MohammadFatehi/ThreePhaseInverter/20190705_152200[1].jpg

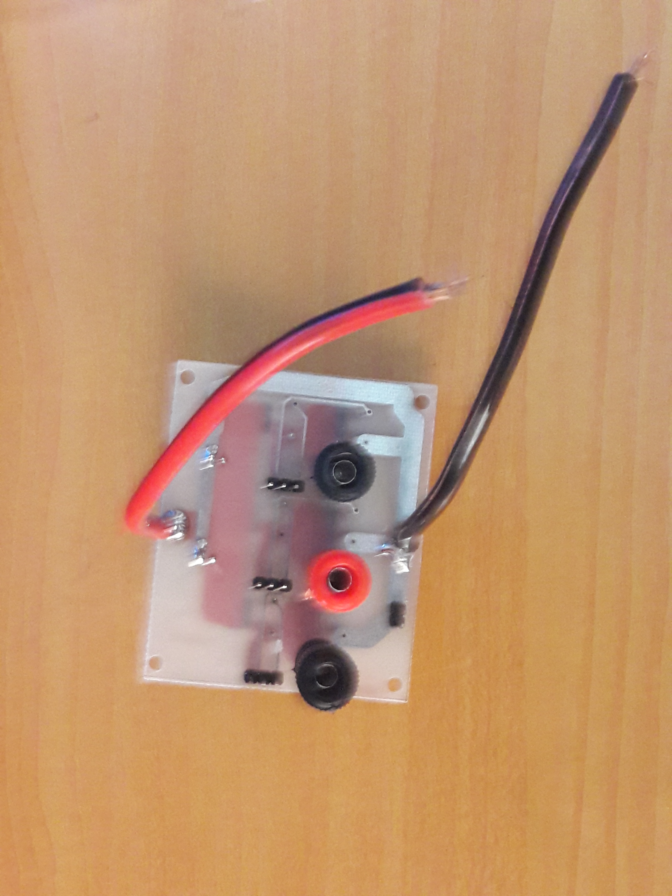
20190705_152200[1].jpg
