MohammadFatehi/ThreePhaseInverter/README.md

# ThreePhaseInverter
This is A Three Phase Inverter Project Developed for Using with Arduino boards.
Made By Mohammad Mahdi Fatehi.
Use PcbDoc and SchDoc for Building Your Own Inverter.
