MohammadFatehi/ThreePhaseInverter/InverterReport.pdf

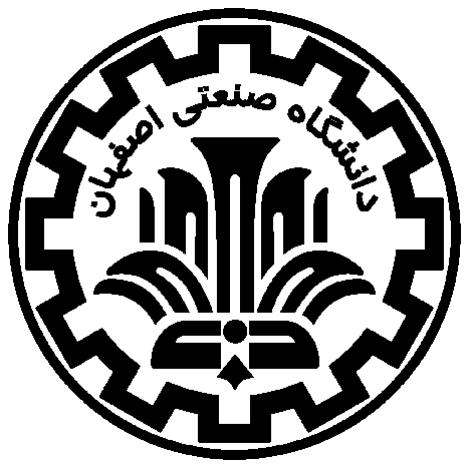
[picture p3: figure]

# طراحی و شبیه سازی به منظور ساخت اینورتر سه فاز

استاد راهنما: دکتر احسان ادیب دانشجو: محمدمهدی فاتحی

تیرماه 1398

الف

# قدردانی

همی شه برای انجام یک کار مطابق اهداف تعیین شده نیاز به ا ستفاده از راهنمایی و م ساعدت دیگران وجود دارد. این پروژه نیز از این قاعده مستثنی نبوده است. لذا قدردانی از این افراد کمترین کاری است که میتوان انجام داد. در این بخش ابتدایی از گزارش پروژه کار شنا سی ، الزم میدانم از ا ستاد عزیزم،آقای دکتر اح سان ادیب که در طول این 9 ماه با راهنمایی علمی و برقرار کردن امکان د ستر سی به آزمای شگاه الکترونیک صنعتی کمک ب سیار بزرگی در را ستای به ثمر ن ش ستن این پروژه دا شتند ت شکر کنم. همچنین از دو ست عزیزم، مجید عمومی که از ابتدای انجام این پروژه به بنده کمک کرده اند و در پایان از کلیه دوستانی که کمک رسان اینجانب بودهاند نیز تشکر میکنم.

1

## فهرست مطالب

قدردانی أ

فصل .1اینورترهای سوئیچینگ 3

.1-1 تعریف اینورتر و کاربردهای آن3 |
.1-2 طبقه بندی اینورترها3 |
.1-3 اینورتر تک فاز نیم پل4 |
.1-4 اینورتر تک فاز تمام پل4 |
.1-5 اینورتر سه فاز5 |
.1-6 تحلیل فوریه اینورتر سه فاز شش پله ای7 |
.1-7 اینورتر سه فاز PWM8 |
.1-8 کاربرد اینورتر سه فاز - کنترل سرعت موتورهای AC 11 |
.1-9 اینورترهای سه فاز چندسطحی11 |
.1-10 خالصه 12

فصل .2طراحی اینورتر سه فاز 13

.2-1 تعریف پروژه و مشخصات آن13 |
.2-2 بلوک دیاگرام پروژه13 |
.2-3 معرفی بخش های مختلف پروژه14 |
.2-4 مروری مختصر بر طراحی PWM20 |
.2-5 مدار فیلتر خروجی22 |

فصل .3شبیه سازی اینورتر سه فاز 25

.3-1 شبیه سازی مدار تولید پالس های مربعی سه فاز با DFF 25 |
.3-2 شبیه سازی مدار قدرت اینورتر سه فاز شش پله ای و نتایج حاصل از آن26 |
.3-3 شبیه سازی مدار قدرت اینورتر سه فاز PWM و نتایج حاصل از آن31 |
.3-4 مقایسه بین عملکرد اینورتر شش پلهای با اینورتر PWM33 |

فهرست مطالب ■ 2

فصل .4محدود کننده جریان و ولتاژ خروجی 35

.4-1 محدود کننده جریان خروجی35 |
.4-2 محدود کننده ولتاژ خروجی37 |
.4-3 طراحی محدود کننده جریان37 |

فصل .5ساخت اینورتر سه فاز شش پله ای 39

.5-1 معرفی بخش های مختلف PCB39 |
.5-2 برد سیگنال39 |
.5-3 برد قدرت.. 42 |
.5-4 دسترسی به فایلهای پروژه43 |

مراجع 45

3

# 1 فصل .1 اینورترهای سوئیچینگ

در این فصل ابتدا به معرفی و تشریح کاربرد اینورترهای سوئیچینگ وتوپولوژیهای مورد استفاده در صنعت پرداخته و سپس در فصول بعدی به تشریح بخشهای مختلف این پروژه میپردازیم.

1-1 تعریف اینورتر و کاربردهای آن

اینورترها در سااده ترین حالت، مدارهایی هساتند که سایگنال DC را به سایگنال AC تبدیل میکنند. لزوم انجام این کار از آن جهت است که معموالً عالقه داریم بتوانیم یک میزان مشخصی توان را از یک منبع DC دریافت کرده و به
3 | موتورهای AC، منابع تغذیه اضاطراری | 2 | یک بار AC تحویل دهیم. در کاربردهایی نظیر کنترل سارعت

، نیروگاه های
خورشیدی، تغذیه لوازم AC از باتری خودرو و دیگر کاربردها از اینورترها استفاده می شود.

1-2 طبقه بندی اینورترها

اینورترهای سوئیچینگ از جنبه های مختلفی قابل طبقه بندی ه ستند. از حیث تعداد فاز، نحوه کلیدزنی، کمیتی که از حالت DC به AC تبدیل می شااود و دیگر موارد. وابسااته به آنکه چه میزان هزینهای برای ما مقدور اساات و در چه کاربردی نیاز به اینورتر داریم، اینورتر مناسب انتخاب میشود. اینورترهای تک فاز در دو نوع نیم پل و تمام پل بسیار مورد اساااتفاده هساااتند. از حیث کلیدزنی، اینورترهای موج مربعی با اینورترهای موج ساااینوسااای متفاوت هساااتند.

1Switching Inverters
2Speed Control
3UPS

فصل .1 اینورترهای سوئیچینگ ■ 4

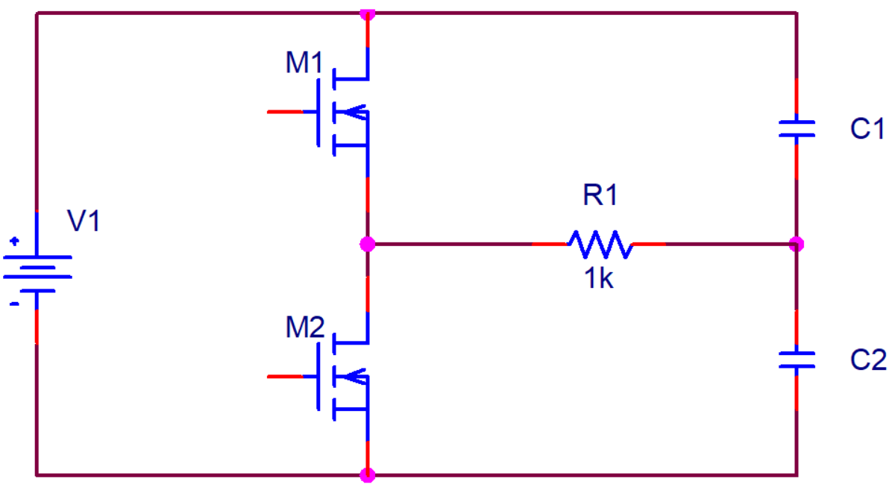
[picture p4: figure]

اینورترهای نوع جریان در برابر اینورترهای نوع ولتاژ هم دیگر دسااته بندی اساات که میتوان انجام داد. در این پروژه
1 | هدف ساخت یک اینورتر ولتاژ ، سه فاز با خروجی موج مربعی)شش پله ای(
است.

1-3 اینورتر تک فاز نیم پل

2

در ابتدا از ساختار تک فاز نیم پل به عنوان یکی از پایهای ترین ساختارهای اینورتری شروع میکنیم. در این ساختار که در شکل )1-1( نمایش داده شده است 2 خازن داریم که ولتاژ آنها با یکدیگر برابر بوده و برابر با نصف ولتاژ منبع تغذیه 1V است. این دو خازن توسط دو کلید دو سمت بار AC سوئیچ میشوند. ابتدا کلید 1Sبسته میشود تا ولتاژی برابر با 1/2V –روی بار قرار گیرد. سپس کلید دیگر ب سته و کلید قبلی باز می شود تا ولتاژی برابر با 1/2V+ دو سر بار 1R قرار گیرد. به این ترتیب با ادامه دادن این روند، یک ولتاژ مربعی با ساااطوث مثبت و منفی دوسااار بار قرار میگیرد.

1-4 اینورتر تک فاز تمام پل

3

در ساختار قبلی ولتاژی که روی بار قرار میگیرد دارای دو سطح بیشتر نیست. اگر بخواهیم سطح صفر ولت را نیز به این سطوث ا ضافه کنیم باید از ساختار تمام پل ا ستفاده کنیم. این ساختار دو کلید بی شتر دا شته و مدار گیت درایو به مراتب پیچیدهتری نساابت به اینورتر نیم پل خواهد داشاات. همچنین عدم همپوشااانی الگوی کلیدزنی در این اینورتر اهمیت دارد. این ساختار در شکل )1-2( ن شان داده شده ا ست. در این ساختار ابتدا کلیدهای 1M و 4M ب سته شده ولتاژ مثبت 1V روی بار قرار میگیرد. ساپس کلید های 1M و 3M بساته شاده و ولتاژ صافر روی بار قرار میگیرد.

1Six Step
2 Half Bridge Single Phase Inverter 3 Full Bridge Single Phase Inverter

شکل .1-1یک اینورتر تک فاز نیم پل

فصل .1 اینورترهای سوئیچینگ ■ 5

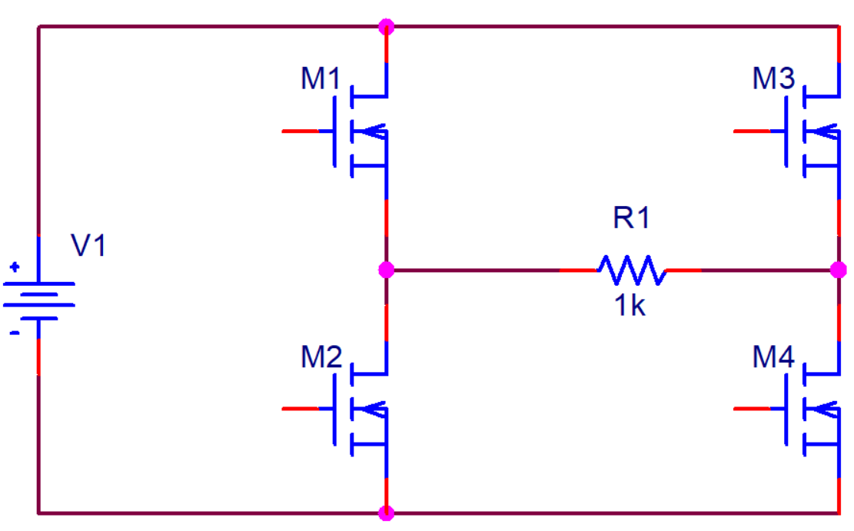
[picture p5: figure]

سپس نوبت به بسته شدن کلید های 3M و 2M میرسد تا ولتاژ منفی 1Vروی بار قرار گیرد. در نهایت 2M و 4M بسته می شوند و مجددا ولتاژ صفر روی بار قرار میگیرد. این روند ادامه پیدا می کند تا یک شکل موج با 3 سطح در
1 | خروجی داشته باشیم. اثبات میشود این خروجی ، نسبت به حالت نیم پل مقدار
THD کمتری دارد و به شکل موج
سینوسی موردنظر نزدیک تر است. وجود یک فیلتر دقیق در خروجی میتواند مولفه سینوسی نسبتا خالصی را از این شکل موج استخراج کند.
هر دو اینورتر یاد شاده دارای محاسابات ریاضای مفصالی در حوزه فوریه بوده که چون به موضاوع این پروژه مرتبط نیسااتند به آنها پرداخته نمیشااود. در بخش بعدی به اینورتر سااه فاز پرداخته و در ادامه این فصاال محاساابات ریاضاای مربوط به این نوع اینورتر را مطرث میکنیم. همچنین ذکر این نکته الزم اساات که ساااختار اینورتر تک فاز به دو نوع مذکور ختم نمیشااود و انواع دیگری نیز دارد. همچنین در روش سااوئیچزنی اینورتر PWM نیز کاربرد فراوانی که این نوع اینورتر در این فصل برای اینورتر سه فاز شرث داده میشود.

1-5 اینورتر سه فاز

این نوع اینورتر میتواند از یک ولتاژ DC ، 3 ولتاژ AC با دامنه یکساااان و اختالف فاز 120 درجهای ایجاد کند. به طور کلی اینورتر سه فاز در مواردی کاربرد دارد که خواهان پردازش توان برای بارهای سه فاز AC هستیم. این بارها شامل انواع موتورهای سنکرون و آ سنکرون)القایی( بوده و کاربردهای ب سیاری دارد. در این نوع اینورتر یک شاخه شامل دو کلید به ساختار تمام پل تک فاز افزوده می شود و با پیروی از الگوی کلیدزنی م شخ صی یک خروجی سه فاز تولید میگردد. ساختار این اینورتر به صورت شکل )1-3( است. در این شکل فازهای A ، B و C مشخص شده اند و یک بار ستاره سه فاز به این فازها مت صل شده ا ست. نقطه N یک نقطه فر ضی ات صال ستاره بوده و زمین مدار مطابق شکل جدا میباشد. مطابق این شکل هر سوئیچ از هر شاخه اگر روشن باشد سوئیچ جفت آن باید خاموش باشد

1Total Harmonic Distrotion

شکل .2-1یک اینورتر تک فاز تمام پل

فصل .1 اینورترهای سوئیچینگ ■ 6

تا از اتصاااال کوتاه شااادن منبع DC جلوگیری شاااود. همچنین هر عمل کلید زنی در هر /6T زمان یک بار اتفاق
که ولتاژهای و سط هر شاخه ن سبت به | ، 0VBو 0VC | میافتد)به عبارتی هر 60 درجه(. مطابق این ساختار ولتاژهای 0VA
زمین مدار اسااات دارای دو ساااطح VDC+و صااافر خواهند بود. ولتاژهای VAB، VBCو VCAولتاژهای خط بوده و

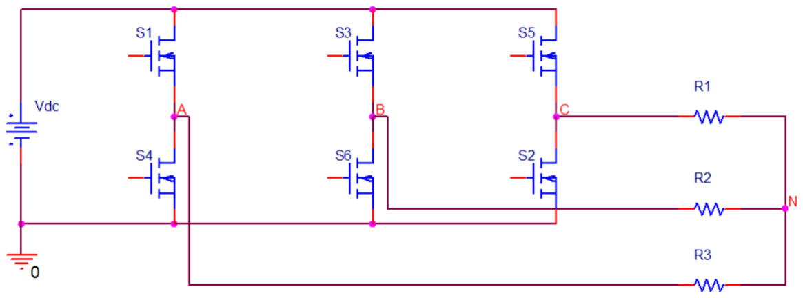
[picture p6: figure]

دارای سطوث VDC+ ، VDC- و صفر میباشند. الگوی کلید زنی در شکل )1-4( نشان داده شده است.

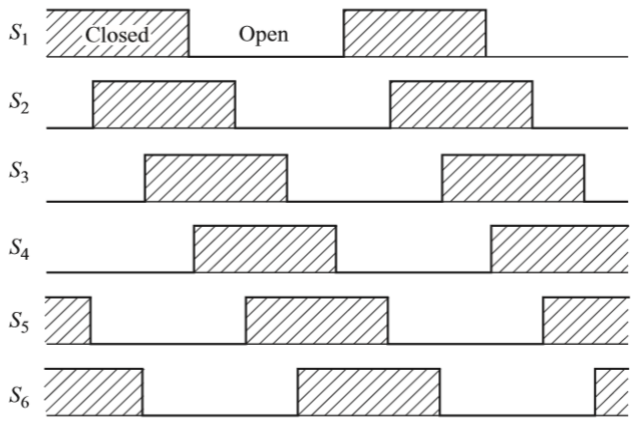
[picture p7: figure]

چنین الگویی شکل موج هایی مطابق شکل )1-5( ایجاد میکند. م شاهده می شود که ولتاژهایی شبیه به سینو سی در خروجی داریم که توساط فیلتر میتوان مولفه ساینوسای آنها را جدا نمود. شاکل )1-6( ولتاژ هر فاز را نشاان میدهد. مالحظه می شاود که این ولتاژ ها دارای ساطوث VDC 1/3 + ، VDC 2/3 + ، VDC 1/3 - ، VDC 2/3 – میباشاد. مالحظه میشود که در یک پریود کلیدزنی ، ولتاژهای فاز 6 حالت مختلف را طی میکنند. به این خاطر به این اینورتر 1 شش پله

نیز گفته میشود.

1Six Step Inverter

شکل .3-1یک اینورتر سه فاز

شکل .4-1الگوی کلیدزنی اینورتر سه فاز

فصل .1 اینورترهای سوئیچینگ ■ 7

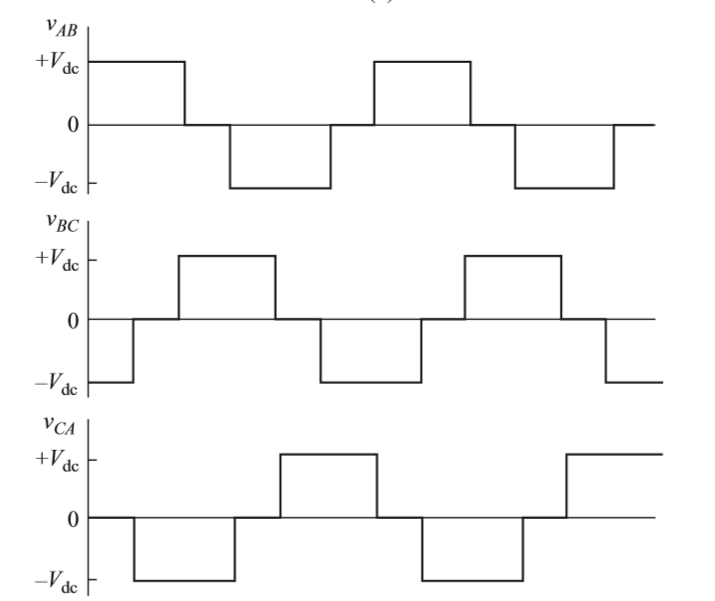
[picture p8: figure]
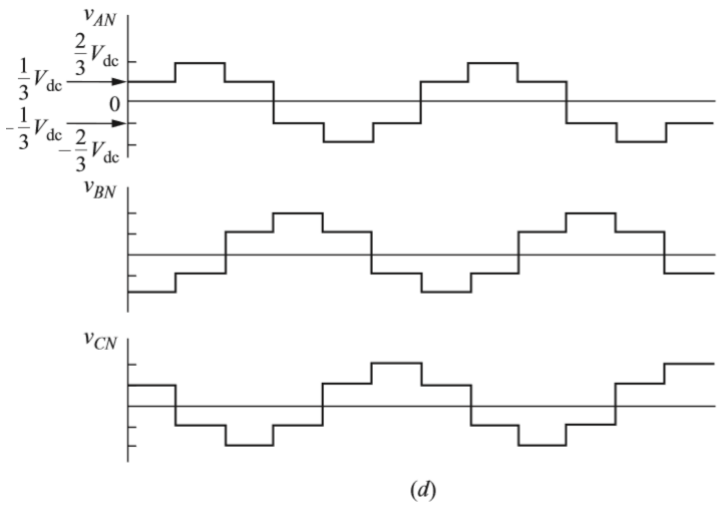
[picture p9: figure]

1-6 تحلیل فوریه اینورتر سه فاز شش پله ای

در این بخش به محاسبات مربوط به اینورتر سه فاز شش پلهای میپردازیم. سری فوریه مربوط به شکل موج خروجی )ولتاژ فاز یا ولتاژ خط( دارای یک مولفه پایه با فرکانس برابر با فرکانس کلیدزنی اسااات. هارمونیک های مربوطه از مرتبه فرکانسااای ±1k6( به ازای ...1,2, = k ) هساااتند. هارمونیک مرتبه 3 و مضاااارب آن وجود ندارند. همچنین

شکل .5-1 ولتاژهای خط اینورتر سه فاز

شکل .6-1 ولتاژهای فاز اینورتر سه فاز

فصل .1 اینورترهای سوئیچینگ ■ 8

هارمونیک زوج نیز ندارد. به ازای بار ستاره که نقطه خنثی آن به زمین مدار مت صل ن شده با شد ، ضرایب سری فوریه ولتاژ خروجی خط و فاز به صورت زیر هستند :

Vn.L-L= |
4VDC

nπ

cos (n
π

6

)| , n = 1,5,7,11,13,… | (1-1)

Vn.L-N= |
2VDC

3nπ

[2+ cos (n
π

3

) - cos (n
2π

3

) ]| , n = 1,5,7,11,13,… | (1-2)

میزان THD مربوط به هر دو ولتاژ خط و فاز خروجی اینورتر در حدود 31 درصد میباشد. این میزان برای جریان بار بخصاااوا بار RL به میزان قابل توجهی کمتر خواهد بود. همچنین فرکانس شاااکل موج خروجی توساااط فرکانس سوئیچینگ قابل تغییر است. دامنه شکل موج خروجی توسط تغییر ولتاژ منبع تغذیه قابل تغییر میباشد.

1-7 اینورتر سه فاز PWM

1

تا کنون به معرفی سااختارهای پایه ای اینورترها پرداختهایم. در این بخش با اساتفاده از سااختار بخش)1-6( به معرفی روشاای به نام PWM میپردازیم که کامال مربوط به نحوه کلیدزنی میشااود. این روش مزایا و معایبی دارد. مزایایی مانند فیلترینگ سااااده تر برای حذف هارمونیک ها و همچنین قابلیت کنترل دامنه خروجی. عیب این روش پیچیدگی مدارات گیت درایو و همچنین باالتر رفتن ناگهانی فرکانس ساوئیچینگ و ایجاد مشاکالت مربوط به آن میشاود. در این بخش ابتدا تعاریف مربوط به این روش کلیدزنی که در اینورتر تک فاز نیز مورداستفاده است بیان شده و سپس به ارائه محاسبات انجام گرفته برای اینورتر سه فاز میپردازیم. در این روش یک موج سینوسی مرجع با یک موج حامل مثلثی مقایسه میشود. فرکانس پایه خروجی برابر با فرکانس موج مرجع میباشاااد و دامنه خروجی متناساااب با نسااابت دامنه موج مرجع و موج حامل اسااات. بدین ترتیب با تغییر فرکانس موج مرجع و تغییر دامنه آن میتوان یک شاااکل موج با دامنه و فرکانس دلخواه در خروجی داشااات. البته مطابق قبل هارمونیکهایی نیز در خروجی وجود دارند. دو تعریف مهم در بحث PWM تعاریف زیر هستند : 1( نرخ مدوالساایون فرکانساای )mf ): به صااورت نساابت فرکانس موج حامل به موج مرجع تعریف میشااود. افزایش این کمیت ، بدان معنا اسااات که فرکانسااای که در آن هارمونیک ها اتفاق میافتند به فرکانساااهای باالتری منتقل می شود. پس مقادیر زیاد مطلوب ه ستند. به این ترتیب چون هارمونیک ها ن سبت به فرکانس اصلی)که برابر فرکانس موج مرجع است( بسیار دور هستند ، فیلتر کردن آنها نیز ساده تر میشود. مشکل در این جا بوجود میآ ید که باال بردن mf یعنی باال بردن فر کانس کل یدزنی که خود مساااائلی مان ند تل فات

1Pulse Width Modulation

فصل .1 اینورترهای سوئیچینگ ■ 9

ساوئیچینگ ، زمان روشان و خاموش شادن و... را دربر دارد و باعث افزایش هزینه و پیچیدگی طراحی می شود.
2( نرخ مدوالسیون دامنه )ma ): به صورت نسبت دامنه موج مرجع به دامنه موج حامل تعریف میشود.به ازای ma کوچک تر از یک ، دامنه هارمونیک ا صلی به صورت خطی با اندازه ولتاژ منبع تغذیه متنا سب میشود. اهمیت تغییر دامنه در روش PWM از آن جهت است که بخصوا در جایی که منبع تغذیه از رگوالسیون خوبی برخوردار نیساات میتوان با تغییر نرخ مدوالساایون دامنه نوعی از رگوالساایون در خروجی را بوجود
آورد. به ازای نرخ مدوالسااایون دامنه بزرگتر از یک حالت فرامدوالسااایون پیش آمده و دامنه به صاااورت
غیرخطی تغییر میکند.
اکنون به توضااایح روش PWM و شاااکل موج های مربوطه میپردازیم. در این روش جفت کلیدهای )4S1,S )و )5S2,S )و )6S3,S )با یکدیگر کنترل میشوند. به آن معنا که در هر جفت اگر یک کلید و صل با شد دیگری قطع است. هر جفت کلید نیازمند یک موج مرجع سینوسی مختص به خود میباشد. یعنی در این روش برای اینورتر سه فاز 3 موج مرجع که هم دامنه و هم فرکانس اند و با یکدیگر 120 درجه اختالف فاز دارند نیاز اسااات. در شاااکل )1-7( یک شکل موج حامل مثلثی و این 3 شکل موج سینوسی مرجع را نمایش میدهد. شکل موج باال به صورت خالصه نتایجی به صورت زیردارد :

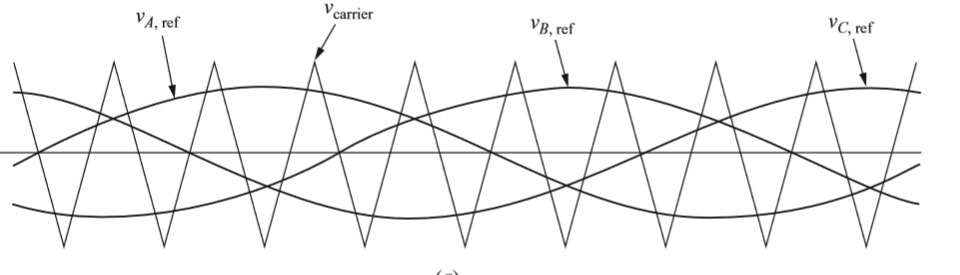
[picture p10: figure]

کلید 1S روشن است وقتی که VTRIG > VA کلید 2S روشن است وقتی که VTRIG > VC کلید 3S روشن است وقتی که VTRIG > VB کلید 4S روشن است وقتی که VTRIG < VA کلید 5S روشن است وقتی که VTRIG < VC کلید 6S روشن است وقتی که VTRIG < VB

شکل .7-1 موج حامل و امواج مرجع

فصل .1 اینورترهای سوئیچینگ ■ 10

در این روش اگر فرکانس موج حامل به صاورت یک عدد صاحیح فرد و مضارب 3 فرکانس مرجع )مانند 3 ، 9 ، 15 و... برابر فرکانس مرجع( باشاد هارمونیک ها کاهش مییابند. در شاکل )1-8( شاکل موج های خروجی نمایش داده شده است.

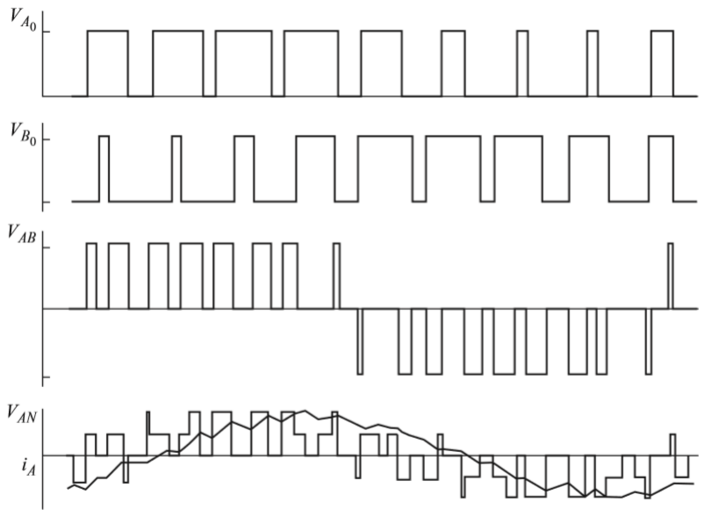
[picture p11: figure]

به دلیل پیچیدگی محاسبات سری فوریه در کتب مختلف جداولی ارائه شده است که دامنه هر ضریب سری فوریه به صورت نرمالیزه شده برح سب دامنه منبع تغذیه ورودی داده شده ا ست. برای اینورتر سه فاز جدولی به صورت زیر وجود دارد :

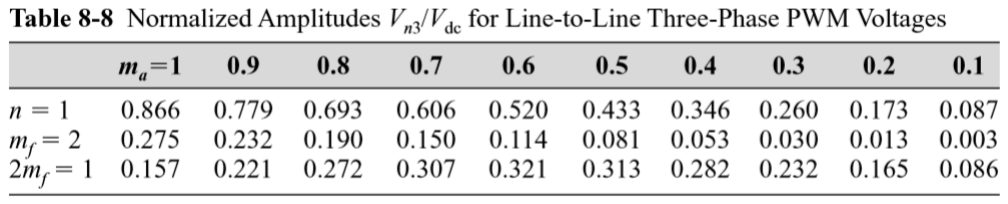
[picture p12: figure]

مشاهده میشود که به ازای ma موردنظر ما ، دامنه ضرایب فوریه مشخص شده اند. در مرجع دوم این پروژه روابط و جداول دیگری نیز آورده شده است که برحسب نیاز میتواند استفاده شود. در این پروژه هدف طراحی ، شبیه سازی و ساخت یک اینورتر شش پله ای ساده است و به طراحی نوع PWM پرداخته نمیشود.

شکل .8-1 ولتاژهای خروجی اینورتر سه فاز PWM

شکل .9-1 دامنه نرمالیزه VDC3/Vn برای ولتاژهای خط به خط

فصل .1 اینورترهای سوئیچینگ ■ 11

1-8 کاربرد اینورتر سه فاز - کنترل سرعت موتورهای AC

یکی از کاربردهای مهم اینورترها در بحث کنترل سرعت موتور القایی است. در این موتورها سرعت سنکرون توسط رابطه زیر با تعداد قطب موتور و فرکانس برق اعمالی به موتور رابطه دارد :
ωs=

2ω

P

(1-3)
با تغییر فرکانس اعمالی به موتور میتوان مستقیما بر سرعت چرخش حوزه دوار )سرعت سنکرون( اثر گذاشت.در این موتورها عدد لغزش به صورت زیر تعریف میشود :
s =

ωS-ωr

ωs

(1-4)
مالحظه میشود که این عدد برح سب سرعت روتور بوده و با گ شتار هم متنا سب ا ست. بدین ترتیب با تغییر فرکانس اعمالی سااارعت موتور تغییر کرده ولی اگر فرکانس کاهش یابد و ولتاژ اعمالی به موتور از لحاظ دامنه ثابت بماند ، شار فا صله هوایی آنقدر زیاد شده که ا شباع میشود و مطلوب ا ست که شار فا صله هوایی در مقدار نامی خود ثابت بماند و همزمان با تغییر فرکانس ، ولتاژ اعمالی هم به همانصااورت تغییر کند به عبارتی نساابت ولتاژ به فرکانس ثابت بماند. به این روش کنترل سرعت موتور القایی ، روش f/V ثابت گویند.

اینورتر سه فاز PWM یک مدار منا سب برای کنترل سرعت به روش یاد شده میبا شد زیرا هم قابلیت تغییر فرکانس دارد و هم قابلیت تغییر دامنه. لذا استفاده از اینورتر غیر PWM مثال اینورتر شش پلهای به دلیل عدم امکان تغییر دامنه خروجی ، کنترل به این روش را ناممکن میکند و مشااکالت روش تغییر فرکانس مثل اشااباع شاادن شااار مغناطیساای بوجود میآید. البته میتوان به کمک یک مبدل DC-DC منبع تغذیه را تنظیم کرد و از اینورتر شااش پلهای صاارفا برای تغییر فرکانس استفاده نمود. استفاده از مبدلهای AC-AC به لینک DC نیز یکی دیگر از راههای کنترل سرعت به روش مذکور به کمک اینورتر شش پلهای است.

1-9 اینورترهای سه فاز چندسطحی

1

چه در روش PWM و چه در روشاااهای دیگر کلیدزنی اینورتر ، میزان THD خروجی بنابر کاربرد میتواند اهمیت فراوانی داشااته باشااد. هرچه THD کوچک تر باشااد خروجی ما به یک سااینوساای واقعی نزدیکتر اساات. با اینحال اینورترهای چندساطحی نیز وجود دارند که خروجی از تعداد ساطوث ولتاژ بیشاتری برخوردار بوده و در نتیجه اثبات میشود که میزان THD کمتری خواهد داشت. یک نمونه از اینورتر سه فاز چندسطحی در شکل )1-10( نشان داده شده است.

1Multi-Level Diode-Clamped Three Phase Inverters

فصل .1 اینورترهای سوئیچینگ ■ 12

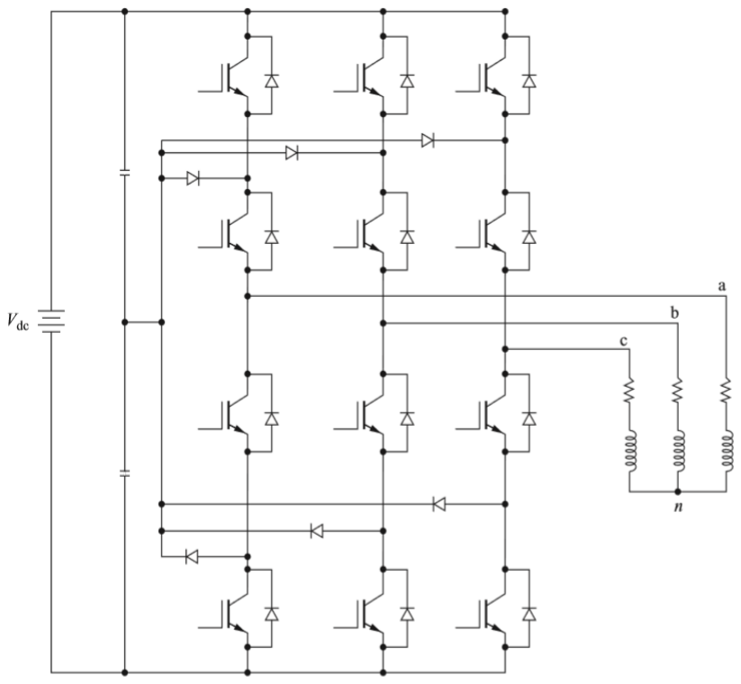
[picture p13: figure]

1-10 خالصه

- مبدلهای تمام پل و نیم پل میتوانند برای تولید خروجی AC از ورودی DC استفاده شوند.
- اینورترها به انواع تک فاز و سااه فاز تقساایم بندی میشااوند که بسااتگی به بار موردنظر مورد اسااتفاده قرار میگیرند
- اینورتر سه فاز شش پلهای پایهای ترین ساختار اینورتر سه فاز است.
- میزان THD در روش PWM نسبت به ساختار شش پلهای بسیار کمتر است.
- روش PWM دارای مدارات گیت درایو پیچیده تر است و هزینه باالتری در برخواهد داشت.
- در روش PWM عالوه بر کنترل فرکانس بر دامنه خروجی نیز کنترل داریم.
- کنترل سرعت موتور القایی یکی از کاربردهای عمده اینورتر سه فاز ا ست که با اینورتر PWM و به روش ولتاژ فرکانس ثابت میتوان کنترل مناسبی بر سرعت داشت.

شکل .10-1یک اینورتر سه فاز چندسطحی Clamped-Diode

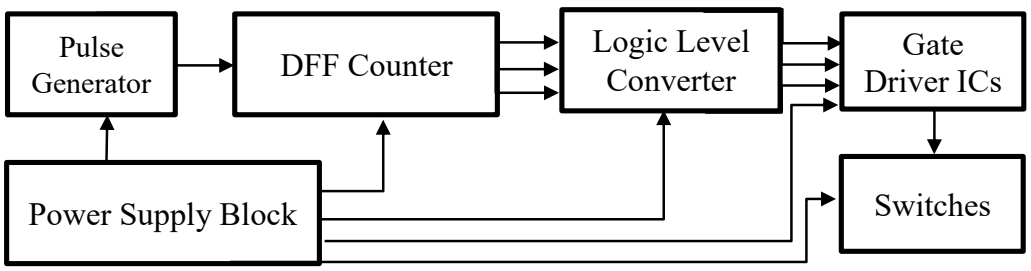
[picture p14: figure]
Pulse; Generator; DFF Counter; Power Supply Block; Logic Level Converter; Gate Driver ICs; Switches

3

# فصل .2طراحی اینورتر سه فاز

.2-1 تعریف پروژه و مشخصات آن

هدف این پروژه طراحی یک اینورتر سه فاز شش پله ای به صورت ماژوالر است که قبال در بخش)1-5( معرفی
1 | شاااد. این اینورتر به منظور کاربردهای ولتاژ پایین مانند درایور موتورهای

BLDC که نیاز به جریان باالیی در هنگام
راهاندازی و زیر بار دارند طراحی ، شبیه سازی و ساخته میشود. این اینورتر قابلیت تغییر فرکانس با استفاده از بلوتوث را نیز دارا بوده و میتواند ولتاژهای مربعی سااه فاز تا دامنه 20 ولت خط به خط و جریان دهی 20 آمپر را فراهم آورد. بازه تغییر فرکانس از حدود 30 هرتز تا 3 کیلوهرتز خواهد بود. توان نامی این اینورتر در حدود 400 وات است.

.2-2 بلوک دیاگرام پروژه

این پروژه از بخش های مختلفی تشااکیل شااده اساات که طبق بلور دیاگرام زیر با یکدیگر ارتباط دارند. این بلور دیاگرام کامل نبوده و بخش به مربوط به بلوتوث در آن وجود ندارد.

1Brushless DC

فصل .2 طراحی اینورتر سه فاز ■ 14

.2-3 معرفی بخش های مختلف پروژه

مدار این پروژه به دو مدار کوچک تر تق سیم شده ا ست. یک مدار که برای گیت درایو و مدار دیگر مدار قدرت که فقط شامل سوئیچ ها و سن سورها ست. این مدار در ف صل 5 آورده شده ا ست و در بخش های بعدی بر ا ساس همین مدار به توضیح بخش های مختلف آن میپردازیم. مهترین بخش مدار این پروژه، کلیدهای قدرت بوده که باید بتوانند ولتاژ و جریان خواسته شده را پشتیبانی کنند. به طور کلی بخش های مختلف این پروژه شامل موارد زیر است : 1( کلیدهای قدرت

1
و توپولوژی اینورتر سه فاز
2( مدار گیت درایو
2
با آیسی 2111IR
3( مدار مولد پالس با فرکانس متغیر
3DFF | 4 )مدار تولید پالس های مربعی سه فاز با استفاده از
5( مدار مبدل سطوث منطقی
6( ماژول بلوتوث به منظور کنترل فرکانس توسط کاربر 7( مدار فیلتر خروجی
الزم به ذکر اسات که طراحی صاورت گرفته در نهایت در فصال بعدی وارد مراحل سااخته شاده و همراه پروژه ارائه میگردد.
.2-3.1 کلیدهای قدرت و توپولوژی اینورتر کلیدهای قدرت مورد اساااتفاده در این پروژه باید بتوانند ولتاژهای معکوسااای به اندازه ولتاژ خط به خط که نهایتا 20 ولت اسات را تحمل کنند. دقت شاود که این 20 ولت دامنه موج مربعی خروجی اسات. همچنین جریان گذرنده قابل تحمل نیز باید بیش از 20 آمپر باشد. به منظور پایین آمدن تلفات ناشی از مقامت درین سورس و عدم تاثیر گذاری آن بر راندمان کلی سیستم نیز از کلیدهایی باید استفاده کرد که مقاومت درین سورس کمی در جریان نامی سیستم داشته
2 | باشند تا تلفات
RDSI حداقل شود. به دلیل آنکه در این پروژه از روش PWM اسفاده نمیشود و نیاز به موج حامل
با فرکانس باال نداریم ، تلفات سوئیچینگ بسیار ناچیز خواهد بود. عالوه بر نکات یاد شده کلیدی که سرعت خاموش و روشاان شاادن باالیی داشااته باشااد نیز در بهبود تلفات سااوئیچینگ نقش عمده ای ایفا خواهد کرد. همچنین به دلیل مالحظات مدار گیت داریو که در بخش بعدی توضااایح داده میشاااود بهتر اسااات کلیدی انتخاب کنیم که میزان بار
4 | الکتریکی گیت
آن یا همان Qg کوچکی داشته باشد. این باعث کاهش سایز خازن بوت استرپ میشود.

1Power Switches
2Gate Drive Circuitry
3D Flip Flop
4Gate Charge

فصل .2 طراحی اینورتر سه فاز ■ 15

توپولوژی فصاال قبل به عنوان توپولوژی این پروژه انتخاب شااده اساات. این توپولوژی نیاز به شااش کلید داشااته که همگی از دیود بدنه معکوس برخوردار باشااند زیرا در قبال بارهای ساالفی جریان در لحظاتی نیاز به مساایری دارد که دقیقا معکوس مسیر روشن بودن کلیدهاست.

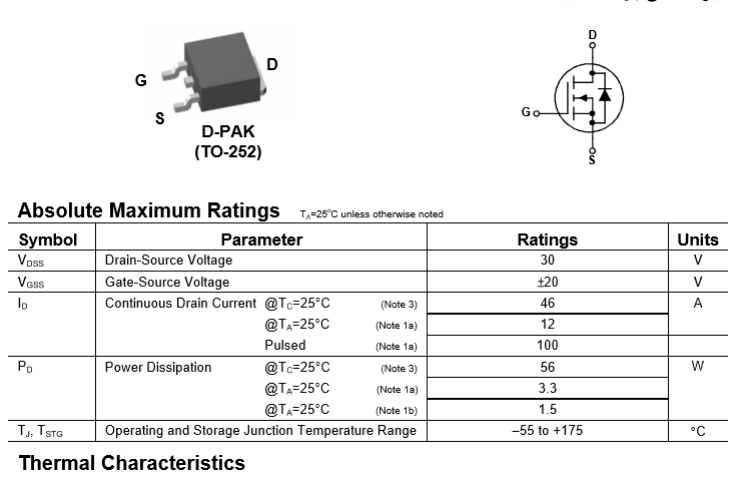
[picture p15: figure]

با توجه به نکات ذکر شاااده، در این پروژه کلیدهای A6690FDD مورد اساااتفاده قرار میگیرد. این کلید دارای مشاخصاات دارای مشاخصااتی مانند ولتاژ قابل تحمل 30 ولت ، جریان 46 آمپر، ساوئیچینگ ساریع، مقاومت درین سورس بسیار کوچک به لطف تکنولوژی PowerTrench و بار گیت کم بوده و در عین حال قیمت بسیار کمی در بازار ایران دارد و بسایار مناساب توضایحات مذکور میباشاد. این ساوئیچ ها در پکیچ -252TO تهیه و در سااخت استفاده میشوند. مشخصات این سوئیچ در شکل )2-1( آورده شده است. .2-3.2 مدار گیت درایو با استفاده از آیسی 2111IR مدار گیت درایو مهمترین مدار این پروژه میبا شد. این مدار باید بتواند عالوه بر تامین جریان الزم برای رو شن کردن سوئیچ سوئیچ هایی که سورس شناور دارند را نیز قطع و و صل کند. راههای مختلفی به این منظور وجود دارد که در این پروژه روش استفاده از آیسی مذکور که یک گیت درایو نسبتا ارزان قیمت ، مطمئن و غیرایزوله را فراهم میکند ، توضیح داده میشود. این آیسی دارای مشخصات نشان داده شده در شکل)2-2( است. در دیتاشیت این قطعه، مدار پیشاانهادی به منظور گیت درایو نیز آورده شااده اساات که در این پروژه از همین مدار اسااتفاده میکنیم. این مدار در شکل)2-3( نشان داده شده است.

شکل .1-2مشخصات کلید مورد استفاده

فصل .2 طراحی اینورتر سه فاز ■ 16

در اینورتر سه فاز چون سه شاخه داریم که هر شاخه دو کلید دارد نیاز به ا ستفاده از 3 عدد از این آی سی وجود دارد. پالس های مربوط به ورودی هر آیسی نسبت به آیسی مجاور خود 120 درجه اختالف فاز دارند. همچنین سوئیچ های

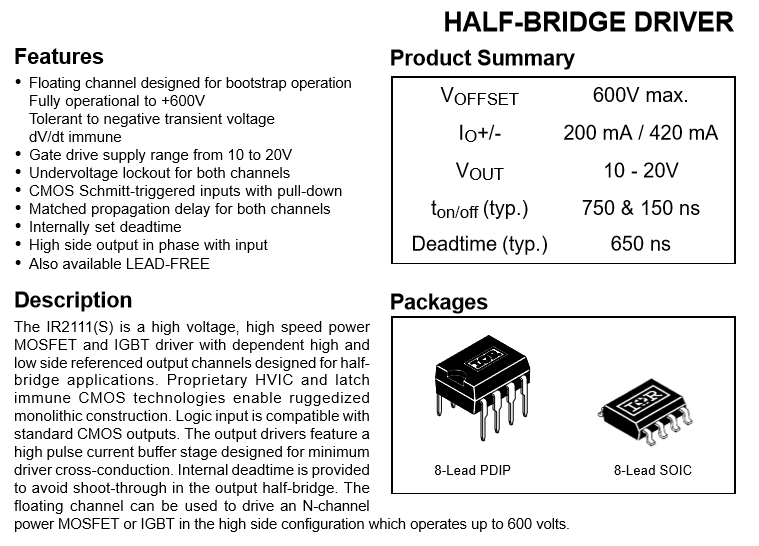
[picture p16: figure]

هر شاخه به ن سبت 180 درجه با یکدیگر اختالف فاز دارند. به دلیل آنکه سرعت قطع و و صل کلیدها محدود ا ست نباید دو سوئیچ همزمان با یکدیگر فرمان بگیرند و اخالف فاز بیش از 180 نیاز ا ست. به عبارتی دیگر نباید همپو شانی بین روشن شدن یک کلید با قطع شدن کلید هم شاخه وجود داشته باشد در غیر این صورت منبع ورودی اتصال کوتاه شده و مدار آسیب میبیند. این آیسی با فراهم آوردن زمان مرده 650 نانوثانیه بین پالس های اعمالی به هر جفت کلید
1UVLO | هم شاخه از ات صال کوتاه منبع ورودی جلوگیری میکند. از دیگر امکانات این آی سی
بوده که در صورت
کاهش تغذیه آی سی به زیر مقدار م شخ صی، عملیات کلیدزنی متوقف می شود. دلیل این کار آن ا ست که اگر ولتاژ تغذیه کم شود و سوئیچ ها با پالس هایی با دامنه کم روشن شوند این روشن شدن مناسب نبوده و ممکن است سوئیچ در ناحیه خطی خود شاروع به کار کند که به دلیل باال بودن ساطح جریان و ولتاژ دو سار آن آسایب خواهد دید. این آی سی ولتاژهای تغذیه تا حدودا 600 ولت را نیز تحمل میکند که ب سیار بی شتر از آنچه در این پروژه نیاز ا ست. تغذیه آیسی به صورت پیشنهادی بین 10 تا 20 ولت است که در این پروژه ما این تغذیه را به صورت مستقیم از منبع ورودی خود دریافت میکنیم لذا محدودیت دیگر این پروژه دامنه تغذیه ورودی بین 10 تا 20 ولت میباشد.

1Under Voltage Lockout

شکل .2-2مشخصات آیسی گیت داریو مورد استفاده

فصل .2 طراحی اینورتر سه فاز ■ 17

برای تغذیه مدارات دیگر از ولتاژهای 5 ولت و 3.3 اسااتفاده شااده که در بخش های آینده توضاایح داده میشااوند. و ضعیت پایه های این کلید همانطور که در شکل )2-3( ن شان داده شده ا ست میبا شد. یک پایه برای پالس ورودی نیاز است که این پالس ورودی به دو پالس یکی هم فاز و دیگری با 180 درجه اختالف فاز نسبت به ورودی به ترتیب به سوئیچ باال و پایین هر شاخه اعمال میشود. این پالس ها همپو شانی ندا شته و همچنین از لحاظ تاخیر انت شار جبران سازی شده اند. پالس سوئیچ باالیی هم فاز با پالس ورودی است. پالس ورودی باید دامنه ای به اندازه 0 تا ولتاژ تغذیه آیسی داشته باشد که این یک ضعف است و در مدار تولید پالس به نحوی آن را برطرف میکنیم. همچنین یک دیود و خازن نیز برای انجام عملیات بوت ا سترپ نیاز ا ست که طراحی مقدار خازن و مالحظات انتخاب دیود در دیتا شیت

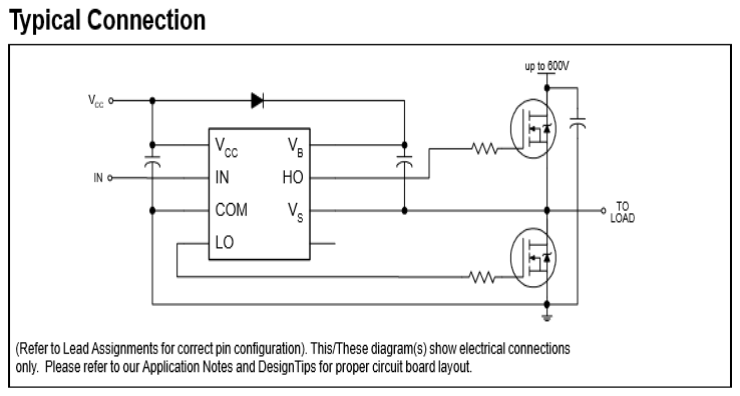
[picture p17: figure]

قطعه توضایح داده شاده اسات و در اینجا به آن نمیپردازیم. در این پروژه متناساب با توضایحات دیتاشایت خازن 10 میکروفاراد انتخاب شد.
این آیسی دارای مدار داخلی مفصلی بوده که تا حدودی آن را توضیح دادیم. در ادامه مطابق شکل )2-4( به توضیح سایر بخش های آن و عملیات بوت ا سترپ میپردازیم. در این آی سی ابتدا ولتاژ ورودی تو سط پایه IN وارد آی سی شااده و باید دامنه بین 0 تا VCC داشااته باشااد. پایه VCC پایه تغذیه آیساای بوده که بین 10 تا 20 ولت در این پروژه مطابق پیشنهاد دیتاشیت انتخاب میکنیم.

شکل .3-2مدار پیشنهادی آیسی گیت داریو

فصل .2 طراحی اینورتر سه فاز ■ 18

در ورودی آیسی یک مدار اشمیت تریگر وجود که به طور خالصه وظیفه آن مقایسه سطوث ولتاژ ورودی IN با یک سطح آ ستانه ا ست به این ترتیب پالس ورودی اگر پالس چندان خوبی از لحاظ زمان صعود و نزول ، نویز و... نبا شد در عبور از ا شمیت تریگر یک پالس منا سب خواهیم دا شت. این پالس منا سب و همچنین حالت اینورت شده آن به ساامت مدارات دو کانال خروجی آیساای یعنی پایه های HO و LO هدایت میشااود. در این مساایر مدارهایی برای ایجاد Time Dead وجود دارد که م شکل همپو شانی را رفع کند. م شاهده میشود که یک گیت NOR نیز وجود دارد که وظیفه بر مقای سه خروجی های مدارات Time Dead با خروجی واحد UVLO را دارد. به این ترتیب اگر خروجی این واحد یک شود و ولتاژ تغذیه کم تشخیص داده شود خروجی این دو گیت صفر خواهد بود و عمال هیچ پالسی برای سوئیچ ها ارسال نمیگردد. سپس در صورتی که شرایط UVLO تشخیص داده نشود پالسهای LOW

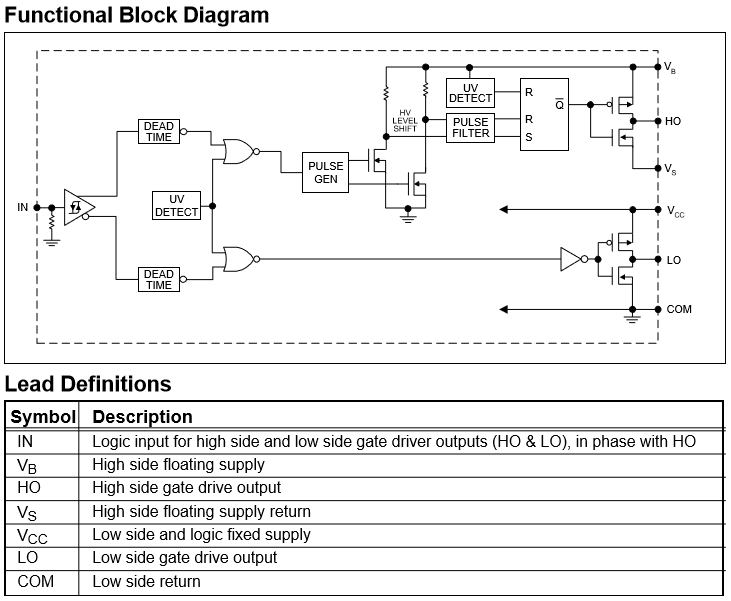
[picture p18: figure]

Side به یک مدار پوش پول ارسااال شااده و پالس های Side HIGH نیز توسااط مداراتی به عالوه مدار پوش پول و ترکیب شدن با خازن و دیود خارجی آی سی عملیات بوت ا سترپ که همان ساخت تغذیه شناور برای درایو سوئیچ هایی با سورس شناور است را انجام میدهد. در انتخاب خازن مشخصات سوئیچ مانند بار گیت و جریان نشتی عالوه بر م شخ صات دیود لحاظ می گردد. خازن باید بتواند موقعی که سوئیچ پایین رو شن میشود از طریق دیود مت صل به

شکل .4-2مدار داخلی آیسی گیت داریو

فصل .2 طراحی اینورتر سه فاز ■ 19

VCC شارژ شده و برای رویداد بعدی کلیدزنی آماده شود تا مثل یک منبع تغذیه شناور عمل کند. سر راه پالس های خروجی آی سی یک مقاومت سری در حد 20 اهم برای میرا کردن نو سانات نا شی از رزونانس خازن گیت و سلف های مسااایر قرار داده میشاااود. همچنین معموال یک مقاومت موازی گیت ساااورس قرار میگیرد تا هنگام قطع بودن سوئیچ گیت کامال تخلیه از بار شود و ناخواسته روشن نشود. در طراحی پی سی بی این آیسی مطابق با دستور العمل ساااازنده مواردی باید در نظر گرفته شاااود تا به بهترین نحو ممکن عملیات کلیدزنی فراهم شاااود. به دلیل پایین بودن فرکانس مدار این پروژه خیلی از مالحظات مربوطه ساده شده و مشکل ساز نمیشوند. عالوه بر نکات ذکر شده پایه COM آی سی با سورس سوئیچ های Side LOW یکی می شود و در این مدار ایزوال سیون بین گیت درایو و مدار قدرت نداریم. یک خازن بزرگ بین تغذیه تا پایه COM نیز برای بهبود جریان دهی به آیسااای و تامین جریان های پال سی قرار داده شده ا ست. این خازن در کنار یک خازن 100 نانوفاراد عد سی میتواند نویز های فرکانس باال را نیز حذف کند و جریان دهی بهتر و تمیز تری در خروجی آیسی داشته باشیم. .2-3.3 مدار مولد پالس با فرکانس متغیر پالسهای موردنیاز آیسی گیت درایو به روش های مختلفی میتواند تولید شود. قبل از آنکه بخواهیم راجع به تولید 3 پالس مربعی با 120 درجه اختالف فاز به 3 آیسی گیت درایو صحبت کنیم ابتدا نیاز به ساخت پالس مرجع داریم. این
1 | پالس که هم فرکانس با فرکانس خروجی اینورتر است در این پروژه توسط یک برد آردوینو
ساخته میشود. از آنجا
که این پروژه به صورت ماژول برای برد آردوینو است ، بهترین روش تولید پالس همین روش است. برای تولید پالس به جای درگیر شدن با رجی سترهای میکروکنترلر AVR صرفا از یک برد UNO ا ستفاده کرده و با تابع tone روی یک پایه دلخواه فرکانس بین 31 هرتز تا 65 کیلوهرتز را میتوانیم تولید کنیم. برای ما تا 3 کیلوهرتز برای این پروژه کافی اساات. به این ترتیب با توجه به قابلیت اتصااال انواع ماژول ها به برد آردوینو میتوانیم به روش های مختلفی این پالس را کنترل کنیم. پالس خروجی را به یک مدار فلیپ فالپ سه طبقه)شمارنده جانسون( داده و مراحل بعدی را پی میگیریم.
.2-1-4مدار تولید پالس های مربعی سه فاز با استفاده از DFF برای تولید سه موج مربعی با اخالف فاز 120 درجه برای سه آیسی گیت درایو از روی پالس مربعی مرجع نیاز به یک مدار شمارنده جانسون داریم که با استفاده از سه عدد DFF پیاده سازی میشود. این مدار به آسانی سه پالس مربعی تولید کرده که هم دامنه با پالس مرجع بوده و این سه پالس با یکدیگر 120 درجه اختالف فاز دارند. پالس اول هم فاز با پالس ورودی اسات. الزم به ذکر اسات که به دلیل سااختار مدار فرکانس این ساه پالس یک شاشام فرکانس پالس

1Arduino

فصل .2 طراحی اینورتر سه فاز ■ 20

ورودی اساات لذا در تابع tone در آردوینو باید فرکانس ماکزیمم که 3 کیلوهرتز بود به صااورت 18 کیلوهرتز وارد کنیم تا پس از عبور از شمارنده جانسون فرکانس پالسها برابر 3 کیلوهرتز شود. .2-1-5مدار مبدل سطوح منطقی به منظور کارکرد صاااحیح مدار ما باید به ولتاژ بخش های مختلف توجه کنیم. پالس مرجع خروجی آردوینو دارای سطح صفر ولت و پنج ولت است. پالس های فلیپ فالپ ها نیز همینطور خواهند بود. لذا تغذیه 5 ولت فلیپ فالپ ها را م ستقیما از آردوینو تامین میکنیم. سپس مدار گیت درایو که گفتیم باید پال سهایی با پیک دامنه برابر با تغذیه خود آیسی داشته باشد لذا باید پالس های فلیپ فالپ ها را از سطوث 0 تا 5 ولت به سطوث 0 تا VCC آیسی گیت درایو ببریم. برای اینکار روش های مختلفی وجود دارد. در این پروژه از یک آپ امپ ارزان قیمت مانند 324LM استفاده میکنیم. تغذیه آپ آمپ را دقیقا همان تغذیه آیسای گیت درایو در نظر میگیریم و سایگنال های فلیپ فالپ ها را با ولتاژ 3.3 ولت روی آردوینو مقایسااه کرده)توسااط آپ امپ بدون فیدبک( و خروجی حاصااله که بین 0 تا VCC آی سی گیت درایو ا ست را به ورودی آی سی میدهیم. ذکر این نکته مهم ا ست که آی سی 74175 که به عنوان DFF استفاده شده است سطح خروجی خروجی حدودا 3.4 دارد. در صورت تست مدار اگر این مقدار کافی نباشد میتوان توسط یک مقاومت و دیود سری یک ولتاژ در حدود 0.7 ولت از روی 5 ولت آردوینو ساخته و به جای ولتاژ 3.3 به عنوان مرجع مقایسه به آپ امپ دهیم. عالوه بر توضیحات فوق سطح ولتاژ تغذیه مدار یا همان تغذیه قدرت که در نهایت دامنه خروجی را میسازد نیز همان تغذیه آیسی گیت درایو را فراهم می آورد. آپ امپ طوری انتخاب شده است که به راحتی تحت تغذیه 20 ولت نیز کار کند.
.2-1-6کنترل فرکانس توسط بلوتوث برای کنترل فرکانس یک راه تغییر فرکانس توسط کدنویسی و تابع tone است. یک راه دیگر به صورت ریموت از راه دور. برای این کار یک ماژول بلوتوث در نظر گرفته و با اتصااال آن به برد درایور اینورتر میسااتقیما از طریق تلفن همراه میتونیم دساتوراتی مثل قطع و وصال و تغییر فرکانس خروجی اینورتر را صاادر کنیم. تغذیه ماژول توساط برد آردوینو و ولتاژ 5 ولت تامین میشود.

.2-4 مروری مختصر بر طراحی PWM

در این بخش به توضااایحاتی راجع به طراحی و مدارات اینورتر ساااه فاز به روش PWM میپردازیم. در این نوع کلیدزنی نیاز به مدارات زیر داریم : 1( مدار قدرت شامل سوئیچ ها 2( مدار تولید موج حامل مثلثی فرکانس باال

فصل .2 طراحی اینورتر سه فاز ■ 21

3( مدار تولید پالس مربعی مرجع 4( مدار تبدیل موج مربعی مرجع به سه موج مربعی مرجع با اختالف فاز 120 درجه 5( مدار تبدیل موج های مربعی سه فاز به موج مثلثی سه فاز 6( مدار تبدیل موج مثلثی سه فاز به موج مرجع سینوسی سه فاز 7( مدار مقایسه کننده موج مرجع سینوسی سه فاز با موج حامل مثلثی 8( مدار گیت درایو
9( مدار فیلتر خروجی
مالحظه میشود که حجم مدارات در این روش بسیار بیشتر از روش قبلی است. البته میتوان میتوان به کمک کدزنی یک میکروکنترلر بخشای از این مدارات را به صاورت دیجیتالی و نرم افزاری پیاده ساازی کرد. در ادامه توضایحاتی راجع به مدارات فوق داده میشود. مدار قدرت همان مدار روش قبلی است. شامل شش سوئیچ در سه شاخه مستقل از هم. مدار تولید موج مربعی مرجع نیز میتواند همان آردوینویی با شد که در روش قبل ا ستفاده شد. مدار شماره چهار یعنی مدار تبدیل موج مربعی تک فاز به ساه فاز نیسات به کمک همان مدار DFF روش قبلی قابل انجام اسات. مدار قسامت پنج یک مدار تبدیل موج مربعی به موج مثلثی اساات که روشااهای بساایاری برای این کار وجود دارد یک نمونه بساایار خوب از این مدار مدار انتگرال گیر اساات. مشااکل این مدار آن اساات که با تغییر فرکانس عالوه بر فرکانس خروجی دامنه خروجی نیز تغییر میکند برای رفع این مشاااکل میتوان از یک آپ امپ بهره قابل کنترل اساااتفاده کرد و کاهش دامنه را جبران کرد. مدار شاماره 6 مدار سااده ای اسات که توساط تعدادی دیود این عمل اتفاق میافتد. این مدار حسااسایتی به فرکانس ندارد ولی با تغییر دامنه ورودی عملکرد مدار مختل می شود. لذا دامنه ورودی باید همی شه ثابت بماند. در نهایت مدار مقایسه که عمال سه عدد آپ امپ است که موج مثلثی ساخته شده فرکانس باال را دریافت کرده و با سه موج سینوسی سه فاز مقای سه میکند. نتیجه مقای سه به مدار گیت درایو ار سال میشود. موج مثلثی فرکانس باال میتواند تو سط یک مدار مانند انتگرال گیر سااخته شاود. این موج فرکانس بسایار باالتر از امواج مرجع ساینوسای داشاته و دامنه آن ثابت است. در نهایت در خروجی اینورتر نیاز به یک فیلتر مناسب برای استخراج مولفه سینوسی موردنظر است. این مدار به دلیل آنکه در نهایت در این پروژه ساااخته نمیشااود در همین حد به توضاایح آن کفایت میکنیم. در فصاال بعد در ق سمت شبیه سازی این مدار از بلور هایی که معادل رفتاری این مدار ا ست ا ستفاده کرده و نتایج را با روش شش پلهای مقایسه میکنیم.

فصل .2 طراحی اینورتر سه فاز ■ 22

.2-5 مدار فیلتر خروجی

برای دا شتن یک خروجی تک فرکانس میتوان از یک فیلتر منا سب ا ستفاده کرد. البته هارمونیک ها در نهایت تاثیر خود را بر خروجی میگذارند ولی در صاورتی که هارمونیک ها در فرکانس های باالتری باشاند و دامنه کمی داشاته باشند با استفاده از یک فیلتر از مرتبه مناسب میتوان به خروجی مناسبی دست یافت. روش کلیدزنی شش پلهای اولین هارمونیک ، هارمونیک مرتبه پنج اسااات و در روش PWM اولین هارمونیک در mf قرار دارد. لذا میتوان گفت که در این دو نوع روش کلیدزنی، با یک فیلتر سااااده باترورث مرتبه دوم نیز میتوان به خروجی خوبی رساااید. البته باید توجه داشات که فرکانس قطع فیلتر پایین گذر به صاورت ثابت خواهد بود و لذا با تغییر فرکانس خروجی به فرکانس های باالتر از مقدار طراحی شده مشکلی پیش نمیآید ولی با کم کردن فرکانس هارمونیک ها به فرکانس های پایین تر آمده و از فیلتر عبور میکنند.
1 | برای طراحی فیلتر نرم افزارها و وبساایتهای بسایاری وجود دارند. در اینجا از وبساایتی
اساتفاده میکنیم که یک فیلتر
خوب و منا سب را به سرعت طراحی کند. یک فیلتر مرتبه دوم چبی شو با فرکانس قطع 3 کیلوهرتز انتخاب میکنیم. طبق این سایت مدار پیشنهادی به صورت یک فیلتر LC خواهد بود. تنظیمات در شکل)2-5( ، مدار در شکل )2-6( و پاسخ فرکانسی در شکل )2-7( نشان داده شده است.

1Rf-tools.com

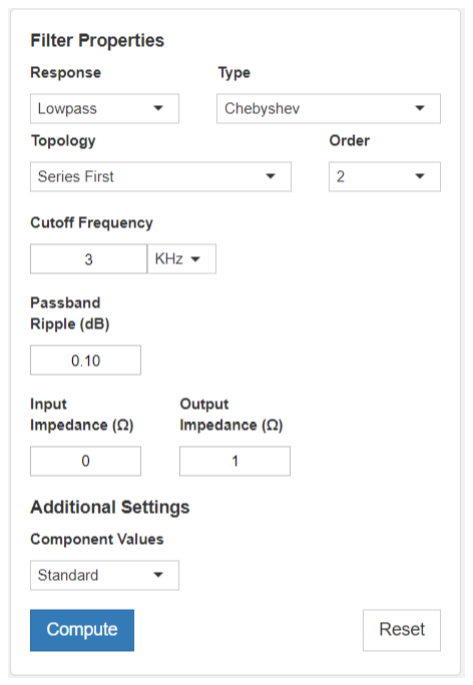
[picture p19: figure]

شکل .5-2طراحی یک فیلتر برای استخراح فرکانس خروجی 1 کیلوهرتز

فصل .2 طراحی اینورتر سه فاز ■ 23

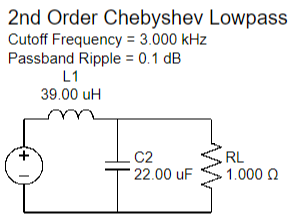
[picture p20: figure]

این فیلتر به دلیل وجود سلف 39 میکروهانری به اندازهی 245 میلی اهم امپدانس سری خواهد داشت که به ازای ولتاژ نامی خط به خط 20 ولت و جریان نامی 20 آمپر این میزان امپدانس برابر با 4.9 ولت افت ولتاژ خواهد بود که مقدار ن سبتا زیادی ا ست. میتوان با تغییر مرتبه فیلتر یا نوع فیلتر این م شکل را برطرف نمود. به طور کلی این سایت یک راه خوب برای طراحی یک فیلتر مناسب است.

شکل .6-2مدار سنتز شده فیلتر موردنظر با مقادیر استاندارد

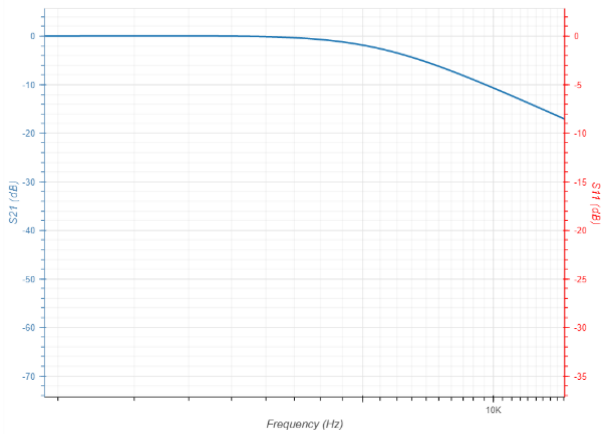
[picture p21: figure]

شکل .7-2پاسخ فرکانسی فیلتر موردنظر

فصل .2 طراحی اینورتر سه فاز ■ 24

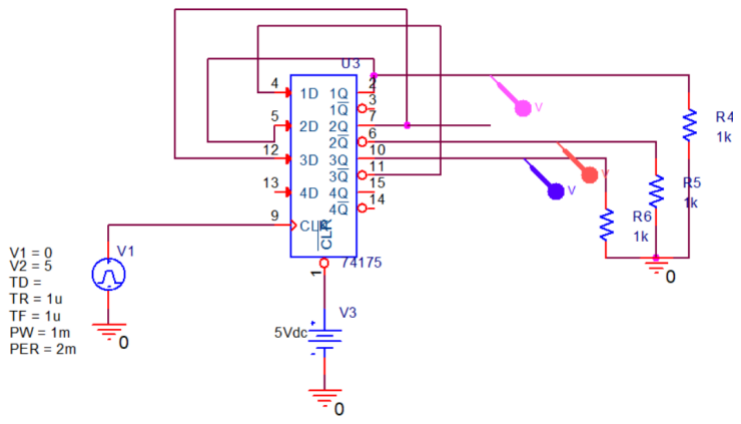
[picture p22: figure]

3

# فصل .3 شبیه سازی اینورتر سه فاز

در این فصل به کمک نرم افزار اورکد و پی سیم به شبیه سازی مدار توصیف شده در فصل قبل میپردازیم. در این شبیه سازی سعی بر آن است که شکل موج های مهم قسمت های مختلف مدار آورده و تحلیل شود. در نهایت مدل رفتاری اینورتر سه فاز PWM را نیز شبیه سازی و به مقایسه عملکرد مدار پروژه با نتایج مدار PWM میپردازیم.

.3-1 شبیه سازی مدار تولید پالس های مربعی سه فاز با DFF

پس از تولید موج مربعی توسااط برد آردوینو باید این موج مربعی به سااه موج مربعی با اختالف فاز 120 درجه تبدیل شود. برای اینکار از مدار شمارندهای استفاده کردیم که در قسمت 2-3-4 توضیح داده شد. برای شبیه سازی این مدار در اورکد از شماتیک شکل )3-1( استفاده شده است.

شکل .1-3شبیه سازی مدار تولید پالس های مربعی سه فاز در اورکد

فصل .3 شبیه سازی اینورتر سه فاز ■ 26

مطابق شکل یک موج مربعی به عنوان مدل خروجی آردوینو به پایه CLK آیسی متصل شده است. سطوث بین صفر تا پنج ولت است. فرکانس این موج در اینجا 500 هرتز است. پایه CLR به ولتاژ 5 ولت وصل شده تا فلیپ فالپ ها در حالت کلیر قرار نگیرند. اتصاالت مطابق مدار فصل قبل است و یک بار سه فاز ستاره نیز برای نمایش بهتر عملکرد مدار به خروجی های موردنظر وصل شده است. خروجی سه فاز مدار در شکل )3-2( نشان داده شده است.

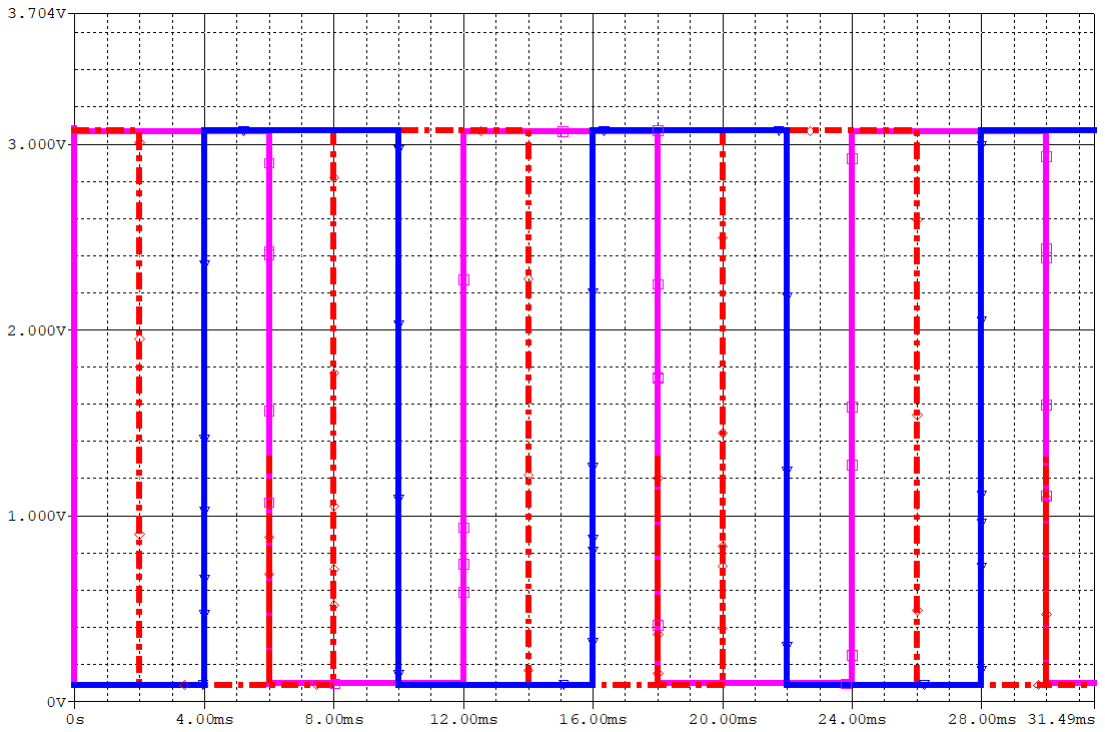
[picture p23: figure]

مشاهده میشود که اختالف فاز 120 درجه ای بین سه خروجی وجود دارد. با تغییر فرکانس ورودی این آیسی به خوبی به تولید شکل موج های مطلوب ما میپردازد. مالحظه میشود که فرکانس شکل موج های خروجی یک ششم فرکانس کالر ورودی است.

.3-2 شبیه سازی مدار قدرت اینورتر سه فاز شش پله ای و نتایج حاصل از آن

با اعمال پالس های ساخته شده به مدار قدرت اینورتر به صورت شکل )3-3( نتایج شکلهای )3-4( ، )3-5( و )3-6( به ترتیب برای ولتاژ خط ، جریان خط و ولتاژ فاز به ازای بار مقاومتی نامی بدساات میآید. مقادیر فرکانس پالس ها برابر 1 کیلوهرتز با ضریب وظیفه 50 درصد با دامنه 20 ولت پیک تا پیک است. تغذیه ورودی 20 ولت در نظر گرفته شده است ، میزان مقاومت ماسفت ها برابر 10 میلی اهم در حالت روشن بودن و ولتاژ دیود بدنه حدود 0.76 ولت در نظر گرفته شده ا ست. این مقادیر م ستقیما از دیتا شیت قطعات ا ستفاده در ساخت پروژه ا ستخراج شده ا ست. بار ابتدا اهمی خالص با میزان یک اهم در نظر گرفته شده است.

شکل .2-3شبیه سازی مدار تولید پالس های مربعی سه فاز در اورکد

فصل .3 شبیه سازی اینورتر سه فاز ■ 27

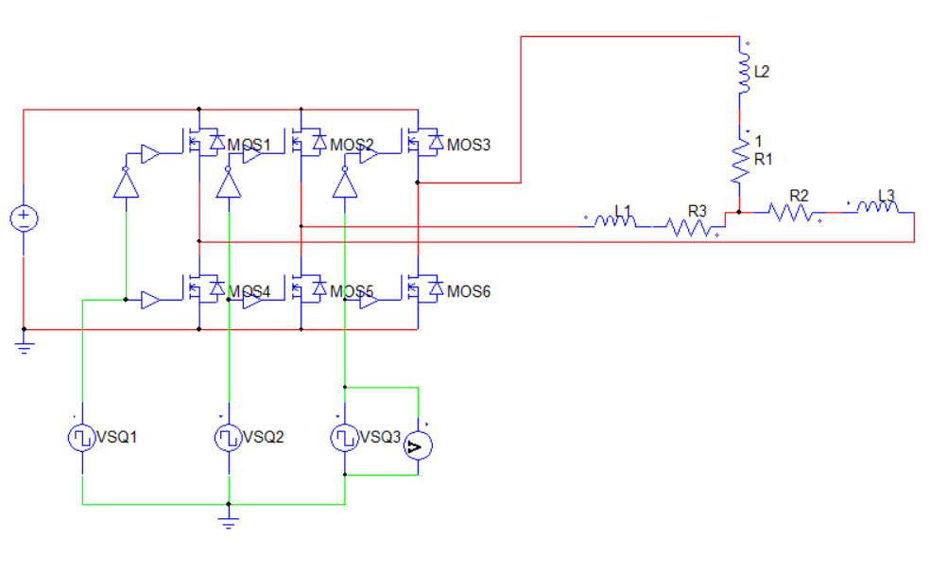
[picture p24: figure]
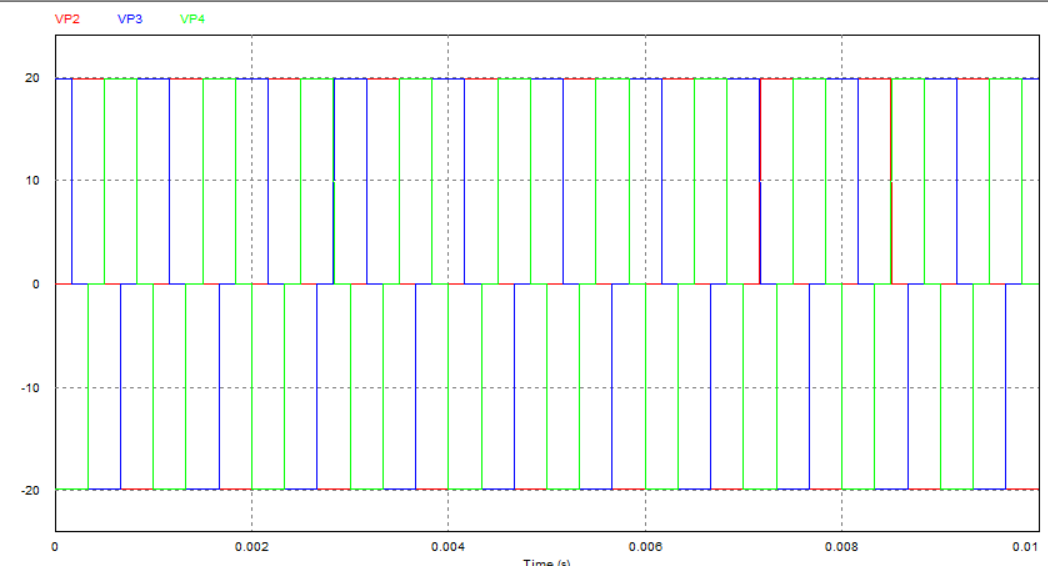
[picture p25: figure]

مشاهده میشود که طبق شکل)3-4( ولتاژ خط دارای دامنه ماکزیمم 20 ولت است. و شکل موج کامال مطابق تئوری بیان شاده در فصال اول اسات. میزان THD موجود در شاکل موج ولتاژ خط برابر اسات با 31 درصاد. این میزان در جریان خط نیز برابر اسات با 31 درصاد. محاسابات به کمک اندازه گیری های موجود در نرم افزار PSIM صاورت گرفته اساات. نکته قابل ذکر دیگر دامنه جریان خط اساات. چون ولتاژ فاز دارای سااطوث دو سااوم تغذیه و یک سااوم تغذیه اسات ، پیک جریان نهایتا دو ساوم پیک ولتاژ تقسایم بر مقاومت اسات.یعنی حدودا 13 آمپر که با شابیه ساازی مطابقت دارد.

شکل .3-3شبیه سازی مدار اینورتر سه فاز شش پلهای در پی سیم

شکل .4-3ولتاژهای خط بار مقاومتی

فصل .3 شبیه سازی اینورتر سه فاز ■ 28

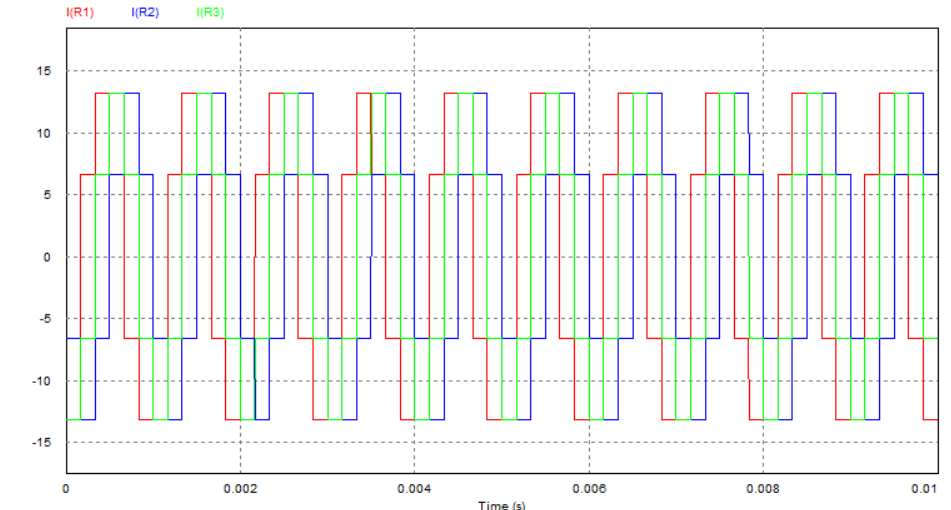
[picture p26: figure]
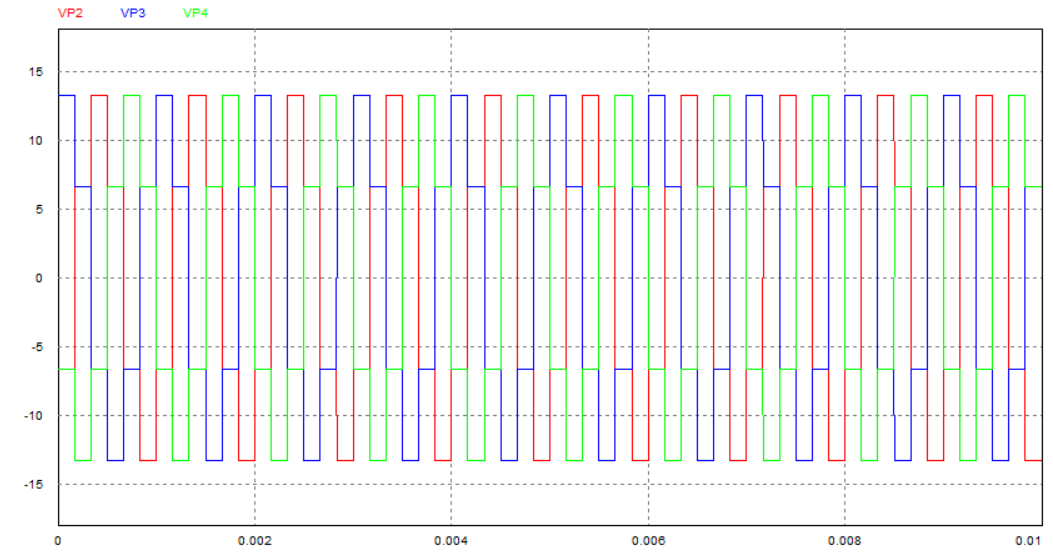
[picture p27: figure]

اکنون بار را به حالت سلفی اهمی درآورده و برای دیدن تاثیر سلف ، یک سلف 1 میلی هانری قرار میدهیم. مالحظه می شود هرچه سلف بزرگتر دامنه جریان کوچک تر ولی به سینو سی نزدیک تر می گردد و میزان THD جریان بار به طرز چ شمگیری بهبود مییابد. شکل موجهای م شابه با حالت مقاومتی در شکل های )3-7( ، )3-8( و )3-9( ن شان داده شاده اسات. میزان THD ولتاژ خط در این حالت برابر با 31 درصاد اسات که فرقی با حالت اهمی خالص ندارد ولی این میزان برای جریان بار حدودا 4.7 درصد است و یعنی 26.3 بهبود داریم که بسیار قابل مالحظه است.

شکل .5-3جریانهای خط بار مقاومتی

شکل .6-3ولتاژهای فاز بار مقاومتی

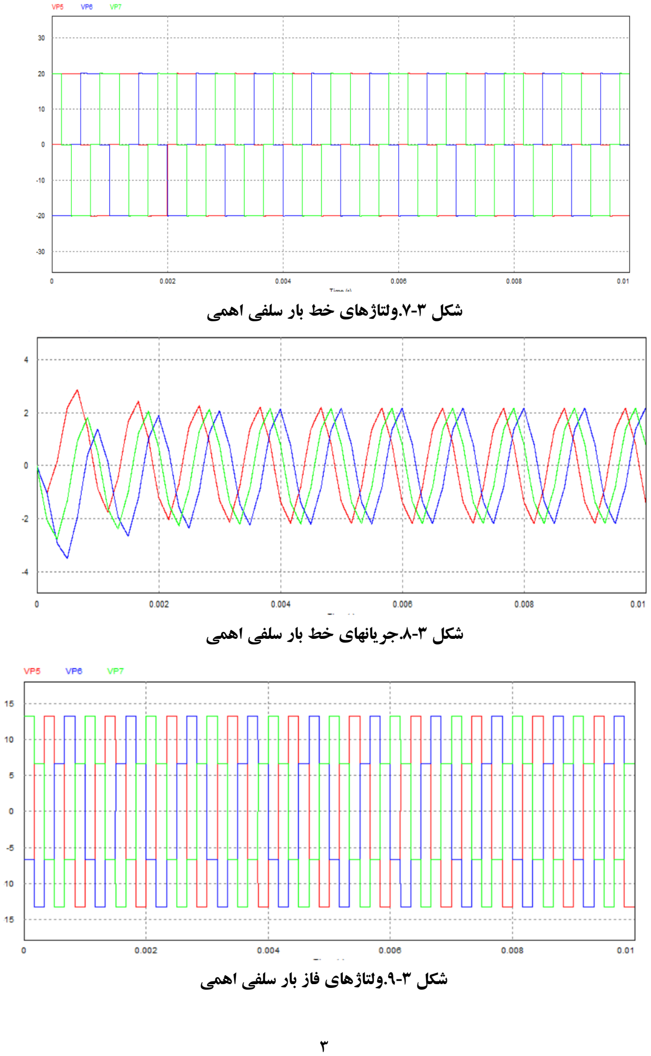
[picture p28: page 31]

3

شکل .7-3ولتاژهای خط بار سلفی اهمی

شکل .8-3جریانهای خط بار سلفی اهمی

شکل .9-3ولتاژهای فاز بار سلفی اهمی

فصل .3 شبیه سازی اینورتر سه فاز ■ 30

اکنون به سراغ تحلیل فوریه شکل موج های ولتاژ خط یکی از دو حالت می رویم. در حالت اهمی سلفی تحلیل فوریه به صاورت شاکل )3-10( اسات. مشااهده می شاود که بزرگترین موله ولتاژ در فرکانس حدود 1000 هرتز اسات که همان فرکانس مطلوب ما اسااات. مولفه بعدی که دامنه ای به اندازه کمتر از یک چهارم دامنه مولفه اصااالی دارد در فرکانس 5 کیلوهرتز است. به این ترتیب صحت نتایج تئوری فصل اول مبنی بر وجود اولین هارمونیک در فرکانس 5 برابر فرکانس هارمونیک ا صلی تایید میشود. می توان برای حالت اهمی و یا برای جریان ها نیز چنین تحلیلی دا شت.

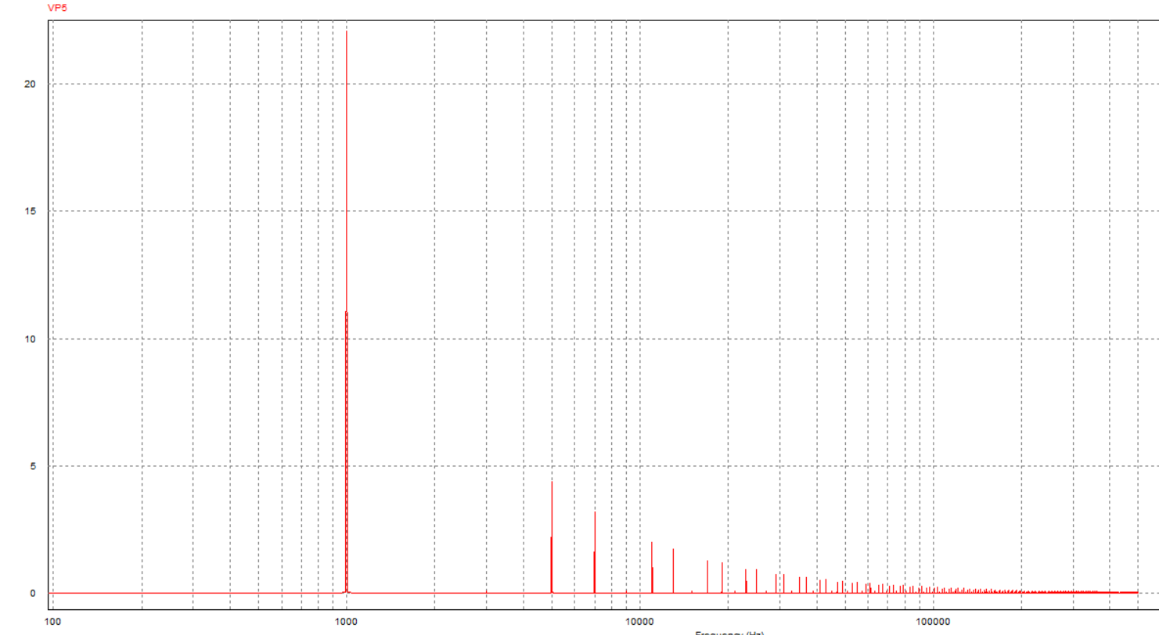
[picture p29: figure]

مثال برای جریان خط در حالت اهمی ساالفی تحلیل فوریه در شااکل )3-11( آمده اساات. مطابق این شااکل مالحظه میگردد که مولفه اصااالی در یک کیلوهرتز بوده و دامنه ای برابر با 2 آمپر دارد درحالی که هارمونیک بعدی که در

شکل .10-3تحلیل فوریه شکل موج ولتاژ خط

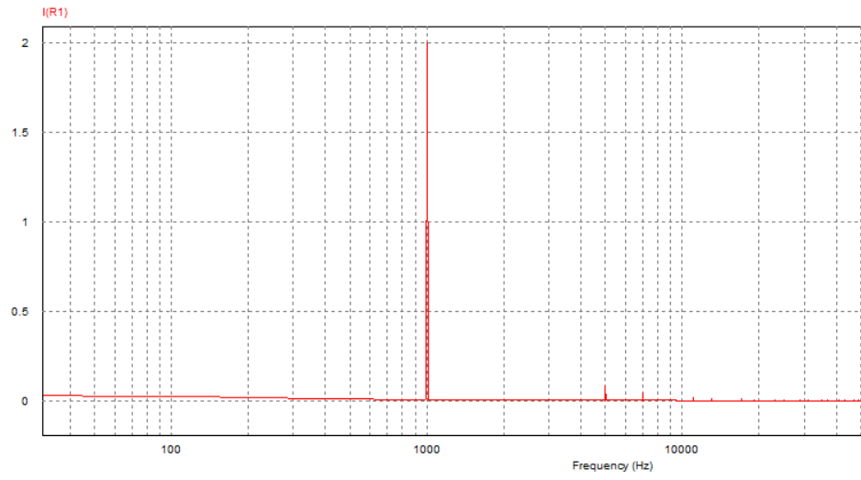
[picture p30: figure]

شکل .11-3تحلیل فوریه شکل موج جریان خط

فصل .3 شبیه سازی اینورتر سه فاز ■ 31

فرکانس 5 کیلوهرتز است دامنهای به اندازه 80 میلی آمپر دارد که بسیار ناچیز است و این همان دلیلی است که باعث شده THD جریان بار بسیار بهبود یابد.

.3-3 شبیه سازی مدار قدرت اینورتر سه فاز PWM و نتایج حاصل از آن

در این قسامت به شابیه ساازی مدار PWM میپردازیم. برای ساهولیت کار این شابیه ساازی در محیط PSIM و به صورت رفتاری انجام می دهیم. مدار شبیه سازی در شکل )3-12( ن شان داده شده ا ست. دامنه موج های سینو سی 5

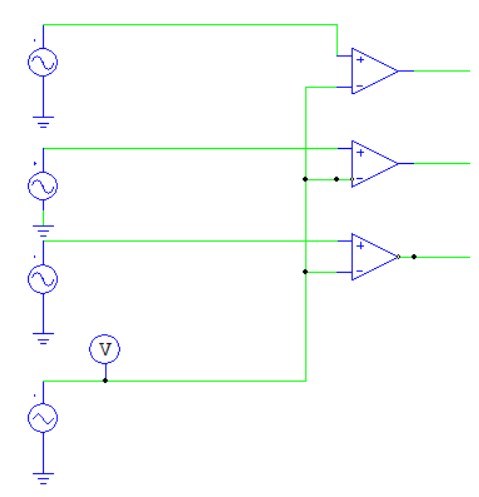
[picture p31: figure]

ولت و دامنه موج مثلثی نیز همین مقدار اساات. به این ترتیب نرخ مدوالساایون دامنه که در فصاال اول تعریف شااد در اینجا برابر یک اساات. اگر بار ساالفی اهمی باشااد و دقیقا همان مقادیر روش شااش پلهای را تساات کنیم و فرکانس

شکل .12-3مدوالسیون PWM

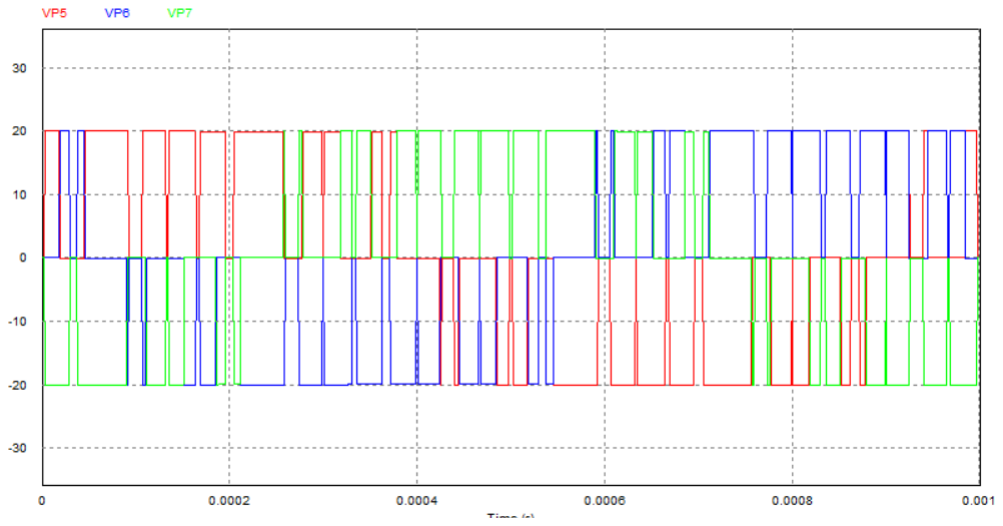
[picture p32: figure]

شکل .13-3مدوالسیون PWM – ولتاژ خط

فصل .3 شبیه سازی اینورتر سه فاز ■ 32

سینو سی ها برابر 1 کیلوهرتز و فرکانس مثلثی برابر 18 کیلوهرتز با شد)مطابق ف صل اول م ضرب 3 از فرکانس مرجع( شکل موج ولتاژ خط ، جریان خط برای بار سلفی اهمی به ترتیب در شکلهای )3-13( ، )3-14( آمده است. مشاهده

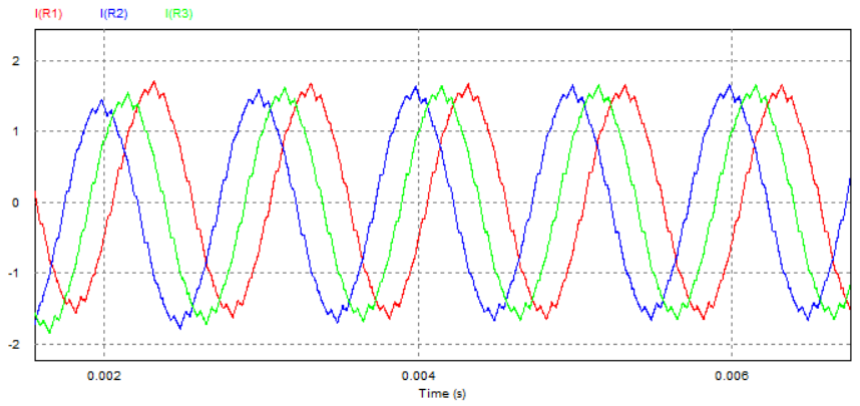
[picture p33: figure]

میشود که شکل موج جریان بسیار شبیه به یک سینوسی خالص است. این به دلیل نقش فیلترینگی است که بار سلفی روی شااکل موج جریان دارد و هارمونیک اصاالی را اسااتخراج میکند. در این حالت THD جریان بار در حدود 2 در صد ا ست. برای دیدن عملکرد روش PWM در حالت تغییر دامنه ، دامنه موج سینو سی مرجع را ن صف میکنیم. بدین ترتیب شکل )3-15(ن شان دهنده شکل جریان خط ه ستند. مالحظه می شود که که پارامتر maتاثیر خود را بر روی دامنه هارمونیک ا صلی گذا شته ا ست. دامنه جریان تقریبا ن صف شده ا ست. این قابلیت یک قابلیت کلیدی در روش PWM است.

شکل .14-3مدوالسیون PWM – جریان خط در حالت 1 = ma

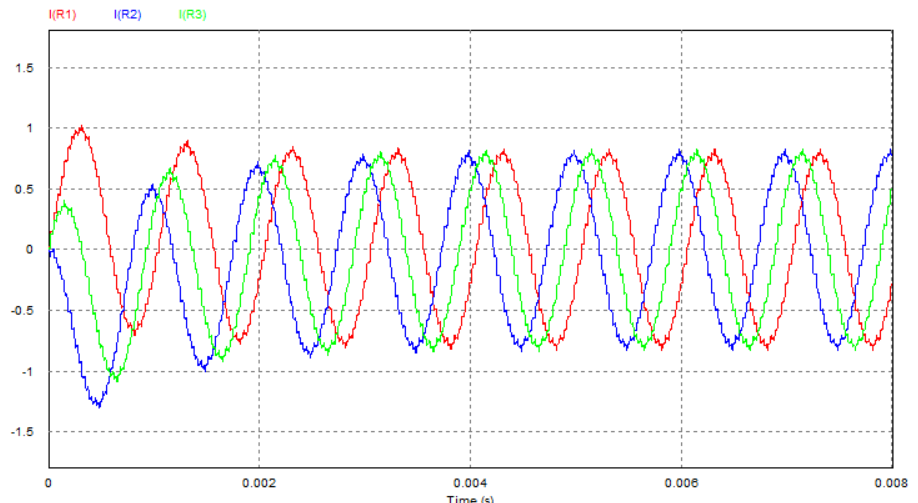
[picture p34: figure]

شکل .15-1مدوالسیون PWM – جریان خط در حالت 0.5=ma

فصل .3 شبیه سازی اینورتر سه فاز ■ 33

اکنون به سااراغ تحلیل فوریه جریان بار در حالت 1 = ma میرویم. مطابق شااکل )3-16( تحلیل فوریه شااامل یک فرکانس اصاالی در فرکانس یک کیلوهرتز با دامنه 1.5 آمپر و مولفه بعدی در فرکانس 13 کیلوهرتز اسااتد دامنه این مولفه 40 میلی آمپر بوده و به وضوث برتری این روش بر روش مسقیم شش پله ای مشخص میشود. به این ترتیب در بخش بعدی این فصل مقایسهای مختصر بین این دو روش انجام میدهیم.

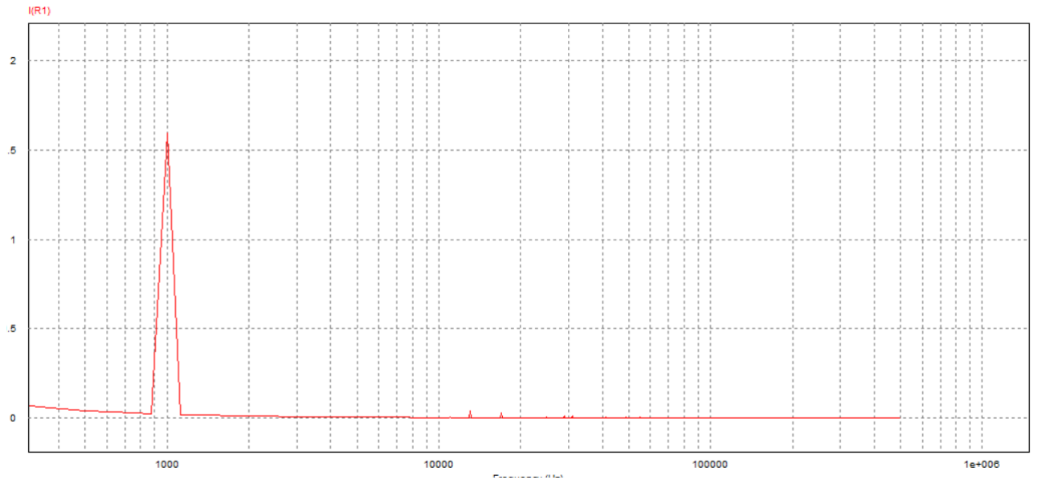
[picture p35: figure]

.3-4 مقایسه بین عملکرد اینورتر شش پلهای با اینورتر PWM

1( هزینه : در این پارامتر هزینه تمام شااده یک اینورتر شااش پلهای به دلیل مدارات ساااده تر و همچنین حجم کمتر مربوط به ساخت PCB کمتر از یک اینورتر شش پلهای خواهد بود. سوئیچ های فرکانس پایین تر نیز در کاهش هزینه نهایی موثر هستند. 2( راندمان : در بحث راندمان پارامترهای زیادی میتوانند دخیل باشاااند ولی به طور کلی با توجه به اینکه در روش شش پلهای فرکانس سوئیچینگ پایین تر است و تلفات سوئیچینگ کمتر است میتوان گفت راندمان باالتری در روش شش پلهای قابل حصول است. 3( پیچیدگی مدارات : مدارات روش PWM به مراتب نیاز به طراحی دقیق تر و پیچیدگی های خاصااای در زمینه پیاده سازی خواهند بود. چه به صورت آنالوگ و چه به صورت دیجیتال این پیچیدگی ها بسیار بیشتر
از شاش پلهای اسات. عالوه بر این در روش PWM پی سای بی مربوطه نیاز به دقت بیشاتری در طراحی و ساخت دارد.

شکل .16-3مدوالسیون PWM – تحلیل فوریه جریان خط

فصل .3 شبیه سازی اینورتر سه فاز ■ 34

4( خلوا فرکان سی : خروجی روش PWM با ا ستفاده از یک فیلتر منا سب ب سیار به سینو سی خالص نزدیک تر است و دامنه هارمونیک های ولتاژ و جریان بسیار کمتر و فرکانس آنها دورتر از فرکانس اصلی است. به طور خالصه THD بهتری خواهیم داشت که در بعضی از کاربردها یک نقطه قوت بزرگ است. 5( کنترل دامنه و فرکانس : در روش شاااش پلهای امکان کنترل فقط فرکانس وجود دارد. در روش PWM به سااادگی دامنه با تغییر دامنه موج مرجع سااینوساای تغییر میکند. این یک مزیت بزرگ بخصااوا در بحث درایو موتورهای القایی است. 6( فیلتر خروجی : در روش PWM طراحی فیلتر سااااده تر اسااات زیرا مول فه های هارمونیکی خروجی در فرکان سهای دورتری ن سبت به مولفه ا صلی ه ستند ن سبت به اینورتر شش پلهای. در نتیجه طراحی فیلتر ساده تر، ارزان تر و از درجه پایین تر امکان پذیر است. نتیجه : در کاربردهایی که هزینه ، ابعاد نهایی مح صول و راندمان اهمیت دارد اینورتر شش پلهای انتخاب منا سبی ا ست. در کاربردهایی که هدف دا شتن یک سینو سی خالص با قابلیت کنترل دامنه و فرکانس ا ست انتخاب یک اینورتر PWM مناسب به شمار میرود.

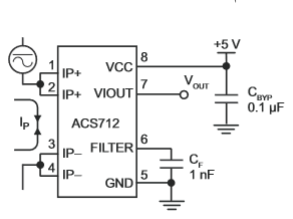
[picture p36: figure]

3

# فصل .4محدود کننده جریان و ولتاژ

پس از توضاایحاتی راجع به تئوری اینورترها ، طراحی و شاابیه سااازی اکنون به مبحثی میپردازیم که درکیفیت نهایی یک اینورتر برای کاربر اهمیت زیادی دارد.

.4-1 محدود کننده جریان خروجی

روشاااهای مختلفی برای محدود کردن جریان خروجی یک اینورتر ساااه فاز وجود دارد. در اینجا به توضااایح روش ا ستفاده از سن سور الکترونیکی میپردازیم. سن سور مورد بحث که متنا سب با پروژه باید ، سن سور جریان 712ACS

است. این سنسور یک سنسور خطی اثرهال با ایزوالسیون 2.1 کیلوولت و مقاومت کم در مسیر عبور جریان است. به

شکل .1-4پایه های 712ACS

فصل .4 محدود کننده جریان و ولتاژ ■ 36

دیلیل کم نویز بودن مسایر عبور جریان و پهنای باند خوب ، این سانساور در اندازه گیری دقیق جریانهای AC و DC بسیار عملکرد خوبی دارد. پایه های این سنسور در شکل )4-1( نشان داده شده است. این ساانسااور با خواندن جریان و تولید یک ولتاژ متناسااب با آن در خروجی خود که به صااورت خطی با افزایش و کاهش جریان تغییر میکند در بدسات آورن عدد جریان به ما کمک میکند. برای اساتفاده از این آیسای مداراتی در دیتاشیت پیشنهاد شده است که در برد قدرت این پروژه از همین مدارات استفاده میکنیم. دو نوع مدار به صورت کلی داریم. مداری که پیک جریان را تشخیص دهد و عدد پیک را به ما بدهد. و دسته دومی مداراتی که عالوه بر ت شخیص پیک آن را با یک مقدار آ ستانه نیز مقای سه کنند و عالوه بر Latch کردن خطای رخ داده ، یک خروجی Fault را فعال ساااازی کنند. به کمک خواندن این خروجی میتوانیم خطا را تشاااخیص داده و

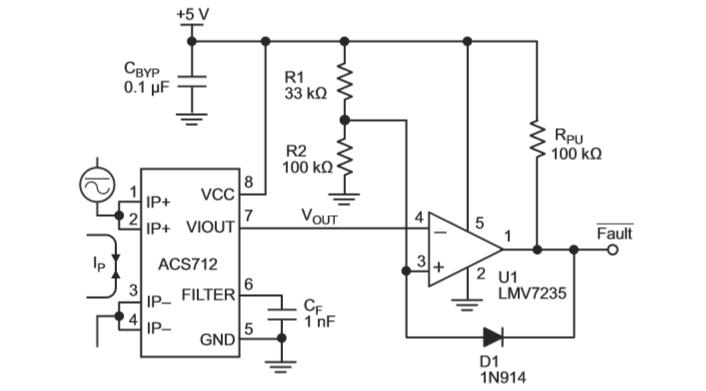
[picture p37: figure]

عملیات کلیدزنی را متوقف کنیم. مدار مورد استفاده در این پروژه برای استفاده از این آیسی به صورت شکل )4-2( است. کارکرد مدار مطابق با منحنی های ارائه شده در دیتاشیت است که در شکل )4-3( نشان داده شده است. مطابق این منحنی در جریان 20 آمپر ولتاژ خروجی در حدود 4 ولت خواهد بود. در مدار مورد ا ستفاده در حالت عادی ولتاژ پایه مثبت آپ امپ از تق سیم ولتاژ بین مقاومت 33 کیلواهم و 100 کیلواهم بدسات می آید که حدود 3.75 ولت اسات و دیود خاموش اسات. به محص آنکه جریان از 10 آمپر بی شتر شود ، مطابق منحنی یک ولتاژ 3.1 ولت در خروجی سن سور خواهیم دا شت. شتر از 10 آمپر شود و این ولتاژ بیشتر از 3.75 شود خروجی آپ امپ به اشباع پایین یعنی صفر ولت رفته، دیود هم روشن شده و ولتاژی به اندازه 0.5 ولت روی پایه مثبت آپ امپ قرار میگیرد. به محص صاافر شاادن خروجی Fault باید آن را توسط آردوینو خوانده و عملیات کلیدزنی را قطع کنیم. این مدار به دلیل استفاده از دیود به شکل فوق مثل یک مدار لچ عمل کرده و تا زمانی که اضاافه جریان برطرف نشاود و تغذیه 5 ولت هم قطع نشاود خروجی تغییر نمیکند. حتی اگر پالریته جریان عوض شااود طبق منحنی ولتاژی کمتر از 0.5 عمال قابل تولید نیساات. و این مدار تا ابد لچ میماند. ا ستفاده از یک دیود با ولتاژ م ستقیم کم در حد 0.4 ولت از الزامات طراحی این مدار ا ست. همچنین بهتر ا ست آپ

شکل .2-4مدار تشخیص اضافه جریان

فصل .4 محدود کننده جریان و ولتاژ ■ 37

امپ بتواند ولتاژی نزدیک به صافر در خروجی تولید کند. با تغییر مقادیر 1R و 2R میتوان ساطح آساتانه را برای این سانساور روی 20 آمپر تنظیم کرد. با تشاخیص Fault توساط آردوینو و صافر کردن فرکانس تولیدی مدار محافظت جریان عمل میکند.

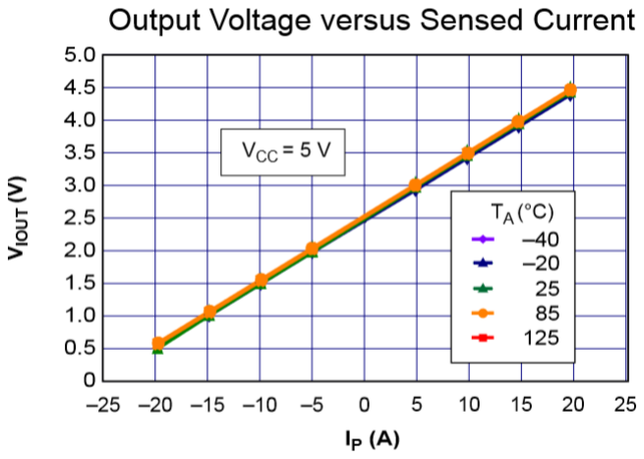
[picture p38: figure]

.4-2 محدود کننده ولتاژ خروجی

برای تنظیم ولتاژ خروجی نیز میتوان از آیساای ها یا روشهای دیگر اسااتفاده کرد. یک مدار ساااده آن اساات که در خروجی اینورتر یک آپ امپ قرار داده و خروجی اینورتر را تو سط یک ت سقیم مقاومتی نمونه برداری کرده و آن را به پایه مثبت آپ امپ وصل کنیم. بر روی پایه منفی یک ولتاژی برابر با آستانه موردنظر قرار دهیم. در صورت تجاوز کردن خروجی اینورتر از مقدار موردنظر ، خروجی آپ امپ به اشباع باال رفته و توسط میکروکنترلر ها قابل تشخیص و کنترل میشود.

.4-3 طراحی محدود کننده جریان

به منظور دا شتن محدود کننده جریان 20 آمپری باید مقاومت های 1R و 2R را طوری انتخاب کنیم که ولتاژ حا صل از تقسیم مقاومتی حدودا 4.5 ولت باشد. با انتخاب k12 = 1R و k100 = 2R این حالت نیز برآورده میشود. برای آپ امپ از یک مقایساه کننده 311LM اساتفاده میکنیم. دیود را نیز یک دیود شااتکی 914n1 انتخاب میکنیم. تغذیه آیسی نیز از طریق 5 ولت برد آردوینو تامین میگردد. خازن بین پایه 5 و 6 نیز برای حذف نویز جریان ورودی اسااات. با انتخاب مقدار مناساااب میتوان با توجه به پهنای باند موردنیاز اقدام به فیلتر کردن نویز جریان کرد. منحنی هایی در دیتا شیت آمده ا ست که به عنوان مثال زمان صعود ولتاژ پایه خروجی سن سور ن سبت به یک جریان پلهای با افزایش خازن ، افزایش مییابد یا دامنه پیک تا پیک نویز با افزایش خازن کاهش مییابد. یک مقدار مناسب برای این خازن حدودا 2.2 نانوفاراد است.

شکل .3-4منحنی ولتاژ جریان سنسور

فصل .4 محدود کننده جریان و ولتاژ ■ 38

3

# فصل .5 ساخت اینورتر سه فاز شش پله ای

در این فصال به تشاریح مراحل سااخت نمونه ای سااده از این پروژه که در فصال های دوم و ساوم به طراحی و شابیه سازی آن پرداختیم ، میپردازیم. در پایان لینکی از سایت GitHub آورده شده که فایلهای پی سی بی ، شماتیک و کد در آن وجود دارد و آن فایل ها را برای آنکه حجم گزارش زیاد نشاود در اینجا نیاوردهایم. الزم به ذکر اسات که مدارات محدود کننده جریان و ولتاژ همچنین مدار فیلتر خروجی جزو اهداف ساااخت این پروژه نبوده و توضاایحات فصول گذشته در این باب در جهت طراحی کامل بوده است و نه استفاده از آن در ساخت.

.5-1 معرفی بخش های مختلف PCB

برای این پروژه یک هدف معین در ساااخت ، ماژوالر بودن به خصااوا در ارتباط با برد آردوینو میباشااد. به همین منظور دو برد با ساایز مناساب یکی برای گیت درایو و تولید سایگنال که با نام برد درایور شاناخته میشاود و دیگری برای سوئیچ های قدرت با نام برد قدرت در نظر گرفته شده ا ست. در طراحی این دو برد سعی بر آن بوده ا ست که سااایز کوچکی داشااته باشااند و همچنین پای های مربوط به تغذیه های برد ، پایه های کنترلی و... به صااورت ساااده و منظمی در آورده شااوند. عالوه بر این در طراحی این PCB ها سااعی شااده اساات که اصااول کلی درباره بردهای سوئیچینگ رعایت شود.

.5-2 برد سیگنال

1

این برد دارای بخش های مختلفی اسااات که در شاااکلهای )5-1( ، )5-2( ، )5-3( ، )5-4( ، )5-5( و )5-6( آورده شده است. این بخش ها قبال به طور مفصل در فصل دوم شرث داده شدهاند. شکل )5-1( مدار تولید پالس های مربعی

1Signal Board

فصل .5 ساخت اینورتر سه فاز شش پله ای ■ 40

سه فاز از روی یک پالس مرجع)آردوینو( را نشان میدهد. این مدار با آیسی 74175 ساخته شده است. تغذیه آیسی

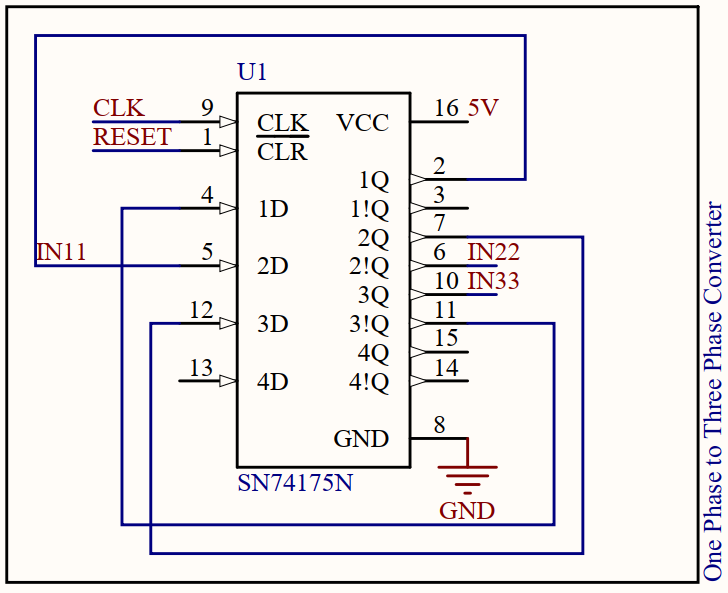
[picture p39: figure]

توساط تغذیه 5 ولتی برد آردوینو تامین میشاود. دو پایه 9 و 1 آیسای نیز که به ترتیب پایه های کالر و ریسات آن ه ستند تو سط به برد آردوینو مت صل می شوند. خروجی های این بخش با نام های 11IN ، 22IN و 33IN م شخص

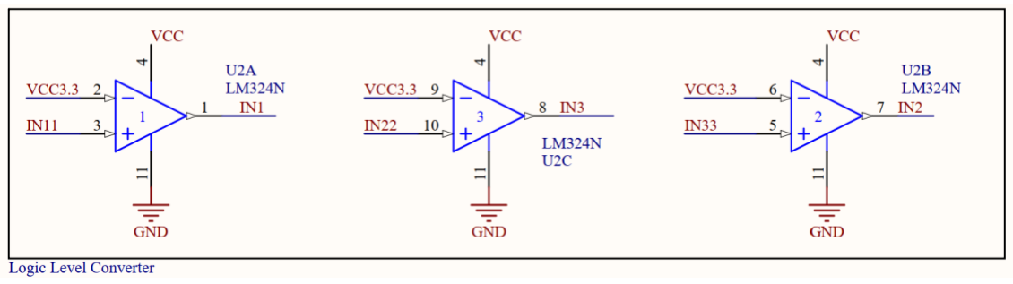
[picture p40: figure]

شده اند که توسط مدار مبدل سطوث منطقی نشان داده شده در شکل )5-2( سطح منطقی این پالس ها از صفر تا پنج ولت به صفر تا مقدار VCC که همان تغذیه مدار گیت داریو و مدار قدرت است تبدیل میشود. آپ امپ های مورد استفاده از نوع 324LM بوده و تغذیه آنها با تغذیه گیت درایو مشترر هستند. الزم بذکر است که تغذیه گیت درایو و مدار قدرت میتوانند از هم جدا با شند. ولتاژ مرجع 3.3 ولتی پایه های آپ امپ ها از طریق آردوینو تامین میگردد ولی به دلیل تفاوت هایی که در خروجی آیساای 74175 وجود دارد و ممکن اساات خروجی آن به سااطح 3.3 ولت نرسااد ، احتماال باید به جای تغذیه 3.3 که از بیرون برای کاربر امکان تغییر آن وجود دارد ، یک مرجع ولتاژ با مقدار حدودا 1 ولت بسازیم.

شکل .1-5 مدار تولید پالس های مربعی سه فاز با DFF

شکل.2-5مدار مبدل سطوح منطقی

فصل .5 ساخت اینورتر سه فاز شش پله ای ■ 41

سپس خروجی آپ امپ ها به پایه های گیت درایو نشان داده شده در شکل )5-3( متصل میشوند. مدار گیت درایو شامل یک سری اتصاالت ، دیود و خازنهایی میشود که در شکل مربوطه نمایش داده شده است. این مدار همان مدار دیتاشیت آیسی است. مالحظه میشود که خازن های 10 میکروفاراد به منظور بوت استرپ استفاده شده اند. همچنین

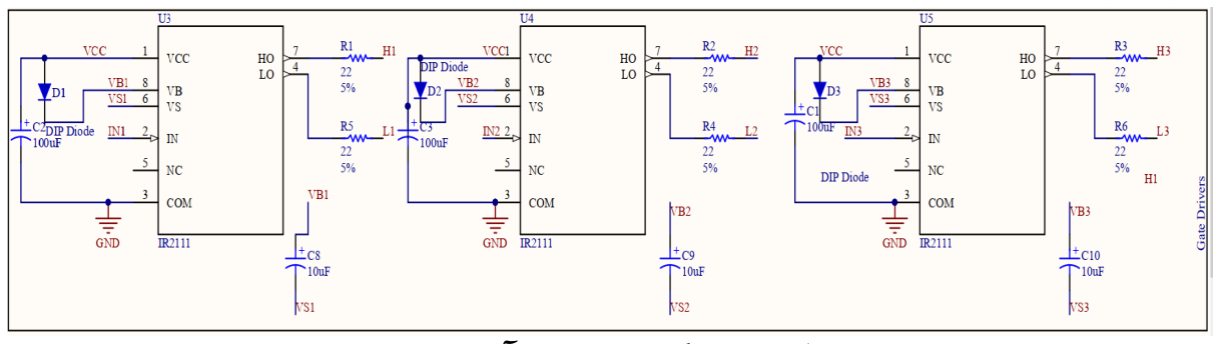
[picture p41: figure]

هر آیسی یک خازن روی تغذیه خود دارد. عالوه بر این مقاومت های 22 اهمی در هر دو خروجی آیسی وجود دارد. در انتخاب خازن ، خازنهایی با ولتاژ پایین در حدود 25 ولت و در انتخاب مقاومت مقاومت های یک چهارم وات انتخاب شده اند. عالوه بر این در برد نهایی خازنهای عدسی 100 نانوفاراد موازی خازن های 100 میکروفارادی تغذیه آیسی وجود دارد.

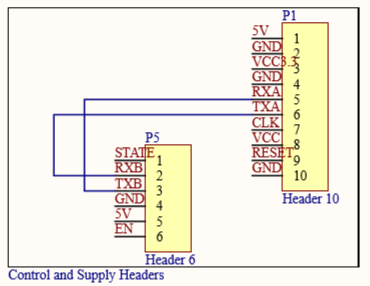
[picture p42: figure]

در شاااکل )5-4( نیز پایه های تغذیه شاااامل تغذیه 5 ولت ، ولتاژ مرجع )تغذیه 3.3 ولت( ، تغذیه گیت درایو)با نام VCC )و تعدادی پایه زمین )GND)، پایه های مربوط به پورت سریال آردوینو ، پایه های مربوط به کالر و ریست آی سی 74175 آورده شدهاند. در شکل )5-4( یک هدر مخ صوا بلوتوث قرار هم وجود دارد. این هدر مخ صوا بلوتوث مدل -05HC بوده که در سمت چپ شکل مذکور قرار گرفته است.

شکل .3-5مدار گیت درایو با آیسی 2111IR

شکل .4-5هدرهای کنترل ، تغذیه و بلوتوث

فصل .5 ساخت اینورتر سه فاز شش پله ای ■ 42

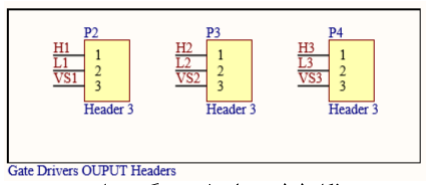
[picture p43: figure]

در شااکل )5-5( هدر مربوط به خروجی های گیت درایو وجود دارد که مسااتقیما به برد قدرت متصاال میشااود. در شاااکل )5-6( نیز تعدادی LED برای نمایش وجود یا عدم وجود تغذیه بخش های مختلف و تسااات مدار قرار دارد.

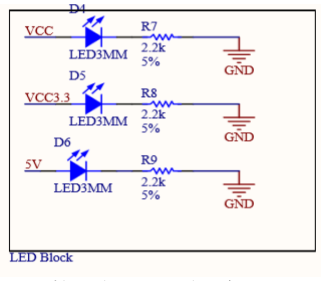
[picture p44: figure]

نحوه دسترسی به پی سی بی مروبوطه در بخش 5-4 شرث داده شده است. این پی سی بی یک پی سی بی دو رو بوده و سعی شده است در چیدمان پی سی بی ، عرض مسیرها و فاصله بین مسیرها نکات مربوطه رعایت گردد تا میزان نویز ، تاخیر و دیگر ا شکالت به حداقل بر سد و پالس های منا سبی به برد قدرت ار سال شود. این پی سی بی سعی شده است تا حد امکان کوچک باشد و توسط هدرهای کناری به راحتی توسط کاربر راهاندازی شود.

.5-3 برد قدرت

این برد شاامل ساوئیچ ها ، خازن های مربوط به هر شااخه ، هدر تغذیه و زمین و مقاومت بین گیت ساورس میباشاد. مدار طراحی شااده در شااماتیک آلتیوم به صااورت شااکل )5-7( اساات. مالحظه میشااود که تعداد سااه عدد خازن الکترولیتی قرار داده شده است که در عمل 100 میکروفاراد هستند و برای هر شاخه یک خازن. همچنین موازی خازن هر شااخه یک خازن عدسای 100 نانوفاراد هم قرار داد که بتواند جریان دهی بهتری داشاته باشاد و نویزهای فرکانس

شکل .5-5هدرهای خروجی گیت درایو

شکل .6-5ال ای دی های نشانگر

فصل .5 ساخت اینورتر سه فاز شش پله ای ■ 43

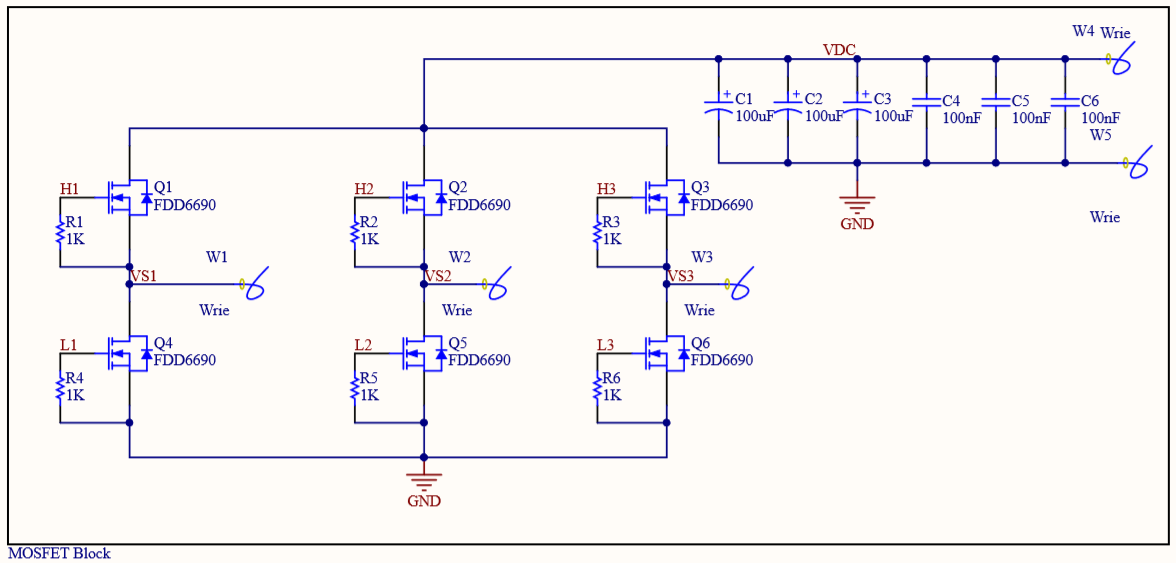
[picture p45: figure]

باال نیز با این ترکیب کاهش پیدا کند. در شاااکل )5-8( نیز هدرهایی را میبینیم که از برد درایور به این برد قدرت مت صل میشوند. نحوه د ستر سی به پی سی بی مربوطه در بخش 5-4 تو ضیح داده شده ا ست. این پی سی بی طراحی ن سبتا پیچیده تری دارد. م سیرهای این پی سی بی باید عرض ب سیار زیادی دا شته با شند که بتوانند جریان دهی بی شتری انجام دهند. همچنین فاصله بین مسیرها نیز مهم تر از پی سی بی سیگنال است. سعی شده است المان ها بسیار نزدیک به یکدیگر باشند و طول مسیرها بسیار کوتاه باشد به این ترتیب مقاومت و سلف مسیرها کم شده و در بهبود کلیدزنی نقش مهمی ایفا میکنند. ترر های مربوط به VCC و زمین مدار نیز عرض ب سیار بی شتری دا شته و سطح بزرگتری از پی سی بی را اشغال کرده اند. همچنین سعی شده تا جای ممکن از VIA استفاده نشود.

.5-4 دسترسی به فایلهای پروژه

به منظور تحقق هدف متن باز بودن پروژه به عنوان یک ماژول برای آردوینو و برای د ستر سی به فایل های پروژه اعم از کد ، شماتیک آلتیوم و فایل پی سی بی، عک سهایی از نمونه ساخته شده مدار و ن سخه پی دی اف همین گزارش میتوانید به سایت GitHub مراجعه کنید. لینک مربوطه در زیر آورده شده است.

شکل .7-5بلوک ماسفت

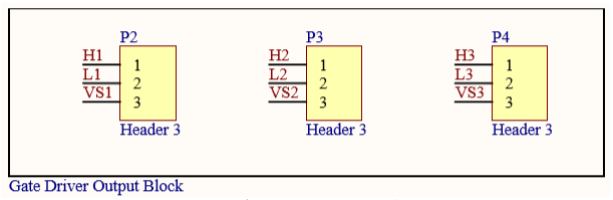
[picture p46: figure]

شکل .8-5هدرهای خروجی گیت درایو

45

# مراجع

1. Millman.j and Taub.H, "Pulse, Digital And Switching Waveforms" McGraw-Hill

Education 1985

2. Daniel.W.Hart, "Power Electronics" 1

st ed., McGraw-Hill Education, 2010

3. R.W.Erickson and D.Maksimovi'c, "Fundamentals of Power Electronics",2nd ed.,

Kluwer Academic, 2001
