MohammadFatehi/ThreePhaseInverter/20190705_152116[1].jpg

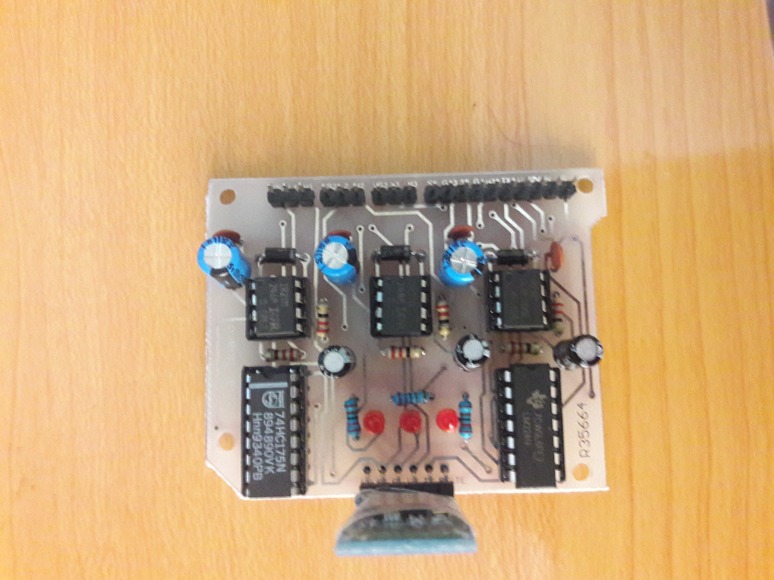
20190705_152116[1].jpg
