MohammadFatehi/ThreePhaseInverter/20190705_152217[1].jpg

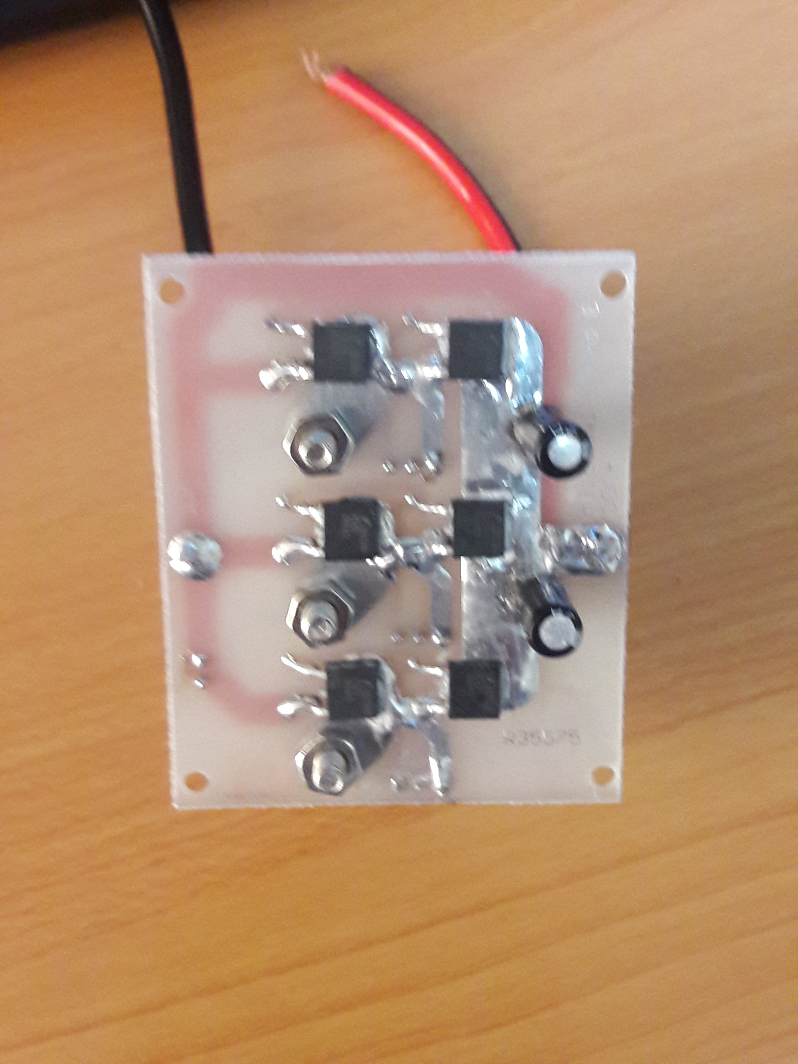
20190705_152217[1].jpg
