MohammadFatehi/ThreePhaseInverter/(list of files, drawings)

Other design files:
PowerBoard.PcbDoc
PowerBoard.SchDoc
SignalBoard.PcbDoc
SignalBoard.SchDoc
