MohammadFatehi/ThreePhaseInverter/20190705_152126[1].jpg

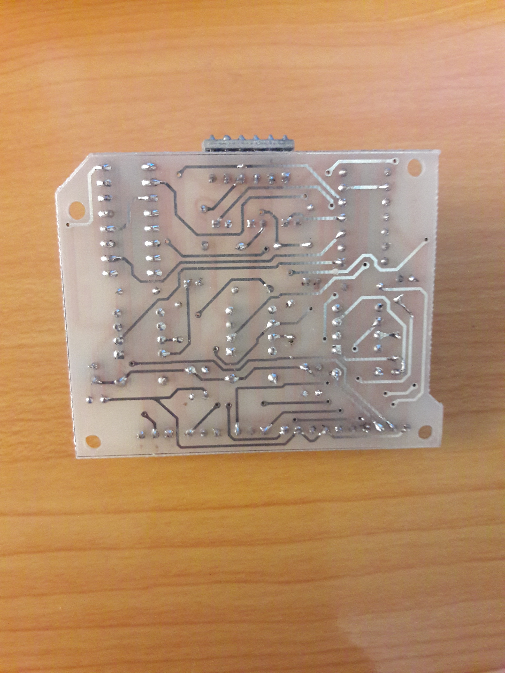
20190705_152126[1].jpg
